horaanlika-droid/pacific/docs/visualization/sborka/PK-900_step3_fronts_all.png

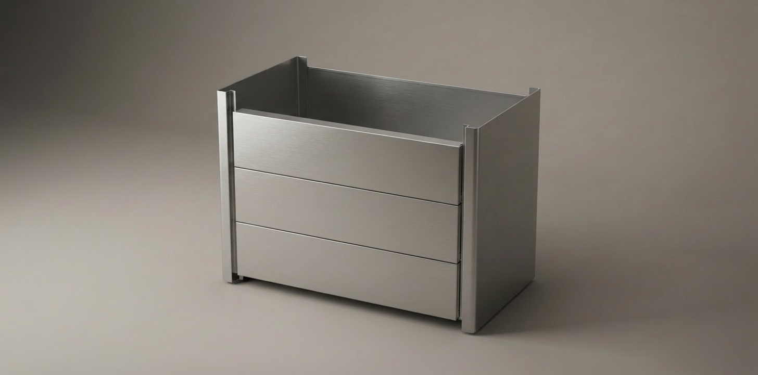
docs/visualization/sborka/PK-900_step3_fronts_all.png
