horaanlika-droid/pacific/docs/visualization/sborka/PK-900_step5_tray_done.png

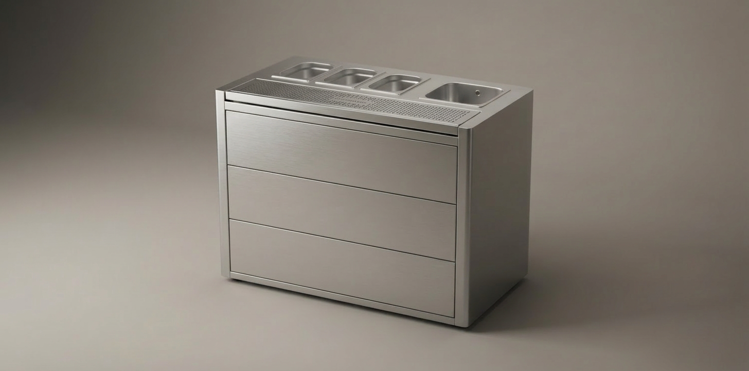
docs/visualization/sborka/PK-900_step5_tray_done.png
