horaanlika-droid/pacific/README.md

# ПАСИФИК ТУРБО · PK-900

Мобильная барная станция из нержавеющей стали AISI 304 для выездных мероприятий.
Металлические элементы вырезаются по отдельности из цельного листа и формуются гибкой;
соединения стойки — без болтов и винтов, по принципу «катана в ножны»: направляемая
скользящая посадка, крючки и пазы. На лотке — сквозная перфорация-логотип «ПАСИФИК ТУРБО»
в динамике советской спортивной эмблемы.

- Габариты в сборе: **900 × 600 × 1050 мм** (борт выдачи 1050 мм, рабочая часть 850 мм — на высоте бедра)
- Масса по параметрической геометрии (рев. D+): металл ≈ 29,7 кг, без чехла (чехол из проекта убран)

## Состав (8 металлических деталей)

| № | Элемент | Развёртка | t | Масса |
|---|---|---|---|---|
| 1 | Стенка боковая левая (ступенчатая 1020 / 820, ребро жёсткости) | 654 × 1071 | 1,2 | 5,67 кг |
| 2 | Стенка боковая правая (зеркально) | 654 × 1071 | 1,2 | 5,67 кг |
| 3 | Фасадный блок нижний | 900 × 375 | 1,2 | 3,21 кг |
| 4 | Фасадный блок средний | 900 × 375 | 1,2 | 3,21 кг |
| 5 | Фасадный блок верхний | 900 × 375 | 1,2 | 3,21 кг |
| 6 | Зона выдачи — перфорированный лоток-каплеуловитель | 900 × 191 | 1,0 | 1,04 кг |
| 7 | Рабочая зона — столешница с вырезами (рёбра жёсткости) | 956 × 516 | 1,2 | 3,42 кг |
| 8 | Перегородка внутренняя (зона льда / мойка, вертикальное ребро) | 502 × 888 | 1,2 | 4,24 кг |

## Что в репозитории

```
cad/pk_geom.py    параметрическая геометрия деталей (мм, K-фактор 0,33)
cad/pk_dxf.py     экспорт DXF: CUT / BEND / INFO / SHEET + раскладка листов
cad/pk_draw.py    чертёжные примитивы и изометрия (reportlab)
cad/pk_album.py   14-листовой альбом A3
docs/             ПАСИФИК_КИТ_альбом.pdf — проект целиком
dxf/              11 DXF деталей (E1–E7, E9, E8.x) + раскладка + INDEX.txt
```

## Принятые допущения

Отверстие мойки принято 300 × 240 мм под рамку GN 1/2 около 325 × 265 мм; проверьте фактическую рамку вашей
ёмкости до заказа резки. Кран в проект не входит (отверстий под фитинг нет). Скользящая посадка и безболтовые замки требуют
контрольной сборки и проверки устойчивости/нагрузки до эксплуатации.

## Сборка

```bash
cd cad
python3 pk_geom.py     # проверка массогабаритов
python3 pk_dxf.py      # dxf/*.dxf + раскладка + INDEX.txt
python3 pk_album.py    # docs/ПАСИФИК_КИТ_альбом.pdf
python3 pk_render.py   # docs/ПАСИФИК_КИТ_визуализация.png
```

Зависимости: `reportlab`, `ezdxf`, `numpy`, `matplotlib` (для попап-версии также `shapely`) (Python 3.11).

## Ключевые решения

- Фасад — три блока 900 × 334 с зазорами 3 мм, лицо 1008 мм; блоки заменяются отдельно.
- Сборка стойки без крепежа: лицевые блоки E3–E5 (ширина 896,6 мм, зазор 0,5 мм) входят
  сверху в вертикальные направляющие-рельсы на внутренней стороне боковин (E1, E2) и снимаются
  вверх; блоки сцепляются шипами, столешница опускается в направляющий зазор на опорные полки.
  Окончательные допуски скользящей посадки должны быть подтверждены контрольным образцом.
- Зона выдачи — съёмный гнутый лоток с продолговатой перфорацией и логотипом «ПАСИФИК
  ТУРБО»; стандартная перфорация освобождает место под надпись. Геометрию дренажа уточнить
  под выбранную ёмкость до выпуска в производство.
- Рабочая поверхность (столешница E7) опущена до **850 мм** (−200 мм от борта выдачи 1050 мм, на высоту бедра бармена) для удобной работы с шейкером, мойкой и льдом; боковые стенки выполнены ступенчатыми (1020 / 820 мм).
- Рабочая зона: сохранены 4 выреза 90 × 160 R8 под малые гастроёмкости; вместо отдельных
  раковин — одно отверстие 300 × 240 R12 под опорную рамку большой съёмной гастроёмкости GN 1/2, используемую
  как мойка. Удалены вырезы под ринсер, кабельный ввод и прямоугольный ввод коммуникаций.
  Кран удалён из проекта по указанию заказчика. Внутренняя перегородка E9 (лист 1,2 мм, 502 × 888, полки 25 и 20 мм, ребро жёсткости; глубина 58–560 мм, за плоскостью фасадов) делит зону льда (4 × GN 1/9) и мойку (GN 1/2) и опирается на низ столешницы и пол.

## Попап из фанеры

Отдельная версия PK-POP-900: [концепция](docs/popup/PK-POP-900_concept.md),
[план отверстий](docs/popup/PK-POP-900_otverstiya.png) и
[файлы отдельных деталей для ЧПУ](docs/popup/cnc/README.md). Рабочая плита и
плита выдачи — фанера со сквозными вырезами; раскладка предварительная и требует
проверки в CAM перед резкой.
