horaanlika-droid/pacific/docs/popup/cnc/README.md

# PK-POP-900 · файлы для ЧПУ

Фанера берёзовая 12 мм, листы 1220 × 2440 мм. Единицы — мм, DXF R2010.

- `PK-POP-01 … 07` — отдельные детали (по одной на файл; количество — в концепции).
- `PK-POP-07` — выдача: плита 900 × 140 со слотами и логотипом (сквозной рез).
- `PK-POP-NEST_sheet1/2.dxf` — раскрой на листы.
- Слои: `CUT` — рез, `DRILL` — Ø4 под винты, `TEXT` — подписи (не резать).
- Вставка мойки — покупная, не в DXF.
- Механизм складывания не нанесён: ждём выбор варианта A или B.
- Генератор: `cad/pk_popup.py`.

## Отверстия в фанерных деталях

- `PK-POP-03_столешница_рабочей_зоны.dxf` — сама фанерная плита
  900 × 460 × 12 мм со сквозными вырезами: четыре 90 × 160 R8 под
  ёмкости и один 300 × 240 R12 под мойку. Начало координат — левый
  нижний угол плиты; левый нижний угол вырезов GN: (48, 55), (156, 55),
  (264, 55), (372, 55); мойки — (535, 55), мм.
- `PK-POP-07_выдача.dxf` — сама фанерная плита 900 × 140 × 12 мм;
  слоты и рисунок логотипа также вырезаются сквозь фанеру. Это не отдельная
  металлическая накладка. Схема обеих деталей: `../PK-POP-900_otverstiya.png`.
- Контуры отверстий находятся внутри контура детали на слое `CUT`; материал
  внутри них удаляется, а не добавляется как отдельная деталь. `DRILL` —
  отдельные предварительные отверстия под крепёж.

**До передачи в производство:** раскладка NEST предварительная: детали в ней
соприкасаются, нет отступа под диаметр фрезы, припуск и прижим. Выполнить
раскладку заново в CAM по отдельным DXF. Надпись «ПАСИФИК ТУРБО» выполнена сквозным трафаретом с перемычками,
без оторванных внутренних островков. Ширина штрихов и слотов 7 мм, радиус
их закруглённых концов 3,5 мм — под фрезу Ø6 мм с запасом 0,5 мм на сторону.
Резать внутренние контуры с компенсацией по внутренней стороне, сделать пробу
и проверить тонкие перемычки и прочность фанеры у изготовителя. Ø4 на слое
DRILL сверлить отдельным сверлом Ø4, фреза Ø6 их не выполнит. Проверить размеры
ёмкостей, крепёж, опору плиты выдачи и влагозащиту всех кромок. Файлы —
концепция, не утверждённое производственное задание.

Генерация: `python cad/pk_popup.py` и `python cad/pk_popup_plan.py`;
зависимости: `ezdxf`, `shapely`, `matplotlib`.
