horaanlika-droid/pacific/docs/flat/PK-FLAT-900_concept.md

# ПАСИФИК ТУРБО · PK-FLAT-900 — конструктор из плоского листа (рев. E)

Статус: **концепция + раскрой для лазера, не инженерный расчёт.** Осуществимость
подтверждена геометрией: 0 гибов, 0 сварки, сборка без инструмента. Узлы и
допуски проверить на макете до заказа металла.

## Задача

Металлическая станция 900 × 600 × 1050 мм из AISI 304, собранная **без единого
гиба**: только вырезанные лазером плоские листы, входящие друг в друга
«лист в лист». В разборе — один плоский пакет.

## Ответ: да, но цена — масса

| | рев. D (гнутая) | **рев. E (плоская)** |
|---|---|---|
| Гибов | 39 | **0** |
| Сварки / крепежа | точечная сварка | 0 / 16 чек Ø4 (необязательно) |
| Деталей | 8 | 13 наименований / 18 шт. |
| Масса | 29,7 кг | **41,2 кг** (+11,6) |
| Пакет в разборе | ≈220–260 мм | **940 × 1030 × 58 мм** |
| Сборка вдвоём | 5–8 мин | 15–20 мин |
| Металл + резка | 33 700 ₽ | 27 000–34 000 ₽ |

Плоская версия тяжелее, потому что вся жёсткость берётся из листа: боковины
набраны полосами, коробка замкнута, лоток — сэндвич из трёх слоёв. Зато нет
гибочного участка, а упаковка в 4 раза тоньше.

## Принцип: шов вместо гиба (J1)

Боковина не гнётся, а **набрана полосами по уровням**, и швы совпадают с
уровнями горизонтальных плит:

```
1050,0 ─┐ ложное дно F10 (торец)
1048,8 ─┼─ бортик F4
1020,0 ─┼─ дно лотка F7 (торец)
1018,8 ─┼─ стойка F3
 850,0 ─┼─ столешница F6 (торец)
 848,8 ─┼─ боковина F2
  21,2 ─┼─ дно F5 (торец)
  20,0 ─┴─ плинтус F1
```

Торец горизонтального листа занимает в плоскости боковины ровно 1,2 мм — это и
есть шов. Стык работает на сжатие «металл в металл», без крепежа и без
отбортовки. Нагрузка идёт по металлу вниз, а не через зазор.

## Четыре типа соединений

| Код | Узел | Как устроен |
|-----|---|---|
| **J1** | шлиц-стык | торец плиты зажат между двумя полосами боковины |
| **J2** | шип-паз | шип **заподлицо**: выступ 1,2 мм (= t), из паза выходит ≤ 0,25 |
| **J3** | гребень | F11 → F12: шип 6,8 мм внутри фасадного сэндвича, спереди заподлицо |
| **J4** | сэндвич | лоток: дно F7 + бортики F8/F9/F4 + ложное F10 = коробка 30 мм |

Шипы и пазы строятся **одной записью в координатах станции** (`pk_flat.py`,
`tab()` / `slot_for()`), поэтому деталь не может «разъехаться» с ответной:
шип 30 мм → паз 30,5 × 1,45.

## Детали

| Код | Деталь | Размер, мм | Шт. | Масса, кг |
|-----|---|---|-----|---|
| F1 | Плинтус боковины | 600 × 20 | 2 | 0,11 |
| F2 | Боковина нижняя | 600 × 828 | 2 | 4,73 |
| F3 | Стойка боковины | 140 × 169 | 2 | 0,23 |
| F4 | Бортик боковины (лоток) | 140 × 29 | 2 | 0,04 |
| F5 | Дно | 900 × 600 | 1 | 5,14 |
| F6 | Столешница (4 × GN 1/9 + мойка GN 1/2) | 900 × 581 | 1 | 3,74 |
| F7 | Дно лотка выдачи (дренаж Ø30) | 900 × 140 | 1 | 1,19 |
| F8 | Бортик лотка (перед / зад) | 898 × 29 | 2 | 0,25 |
| F10 | Ложное дно (перфорация, трафарет) | 898 × 120 | 1 | 0,92 |
| F11 | Фасад нижний (2 шлица) | 898 × 828 | 1 | 7,03 |
| F12 | Фасад верхний (барьер) | 898 × 169 | 1 | 1,44 |
| F13 | Задняя панель | 900 × 828 | 1 | 7,09 |
| F14 | Перегородка лёд / мойка | 502 × 828 | 1 | 3,95 |
| F15 | Чека Ø4 × 18 (пруток) | Ø4 × 18 | 16 | 0,3 м |

Итого: 4,33 м², 41,2 кг, рез 51,6 м. Раскрой: 2 листа 1250 × 2500
(S1 — 14 деталей, 2,53 м²; S2 — 4 детали, 1,80 м², 58 %).

## Пакет в разборе

18 листов + 18 прокладок 2 мм (войлок/картон) → **940 × 1030 × 58 мм, 41 кг**.
Две стяжки, угловые накладки, ремень. Мойка, бутыль для дренажа и U-профиль
уезжают отдельно, в той же сумке.

## Допуски

- паз = t + 0,25 = **1,45 мм**; первый комплект — с зазором 0,25, туго → 0,15,
  болтается → чеки Ø4 / заклёпки;
- шип **заподлицо**: выступ 1,2 мм, из паза выходит не более 0,25 мм;
- гребень F11 → F12 — 6,8 мм (спрятан в фасаде);
- внутренние углы пазов и шлицев — **R0,5** (тонкий лист не любит острых
  входящих углов);
- кромки притупить 0,3 × 45°, фасад и столешницу — шлифовка 400 → 600;
- U-профиль 1,5 мм на верхнюю кромку фасада и на кромки лотка.

## Порядок сборки (12 шагов, 15–20 мин вдвоём)

F5 → F1 → F2 → F13 → F14 → F11 → F6 → F12 → F3 → F7 → F8/F9 + F4 → F10.
Разборка — строго наоборот.

## Файлы

- `PK-FLAT-900_альбом.pdf` — альбом A3, 6 листов: обложка, узлы, слои и укладка,
  спецификация и раскрой, сборка, смета и риски.
- `cnc/PK-FLAT-F*.dxf` — 13 деталей 1:1 в координатах станции (деталь = проекция
  станции), слои `CUT` / `INFO` (подписи не резать).
- `cnc/PK-FLAT-NEST_s1.dxf`, `cnc/PK-FLAT-NEST_s2.dxf` — раскрой на листы.
- `cad/pk_flat.py` — параметрика, соединения, проверки (`python pk_flat.py`).
- `cad/pk_flat_dxf.py` — выгрузка DXF и NEST.
- `cad/pk_flat_album.py` — сборка альбома (`python pk_flat_album.py`).

## Проверки в модели

`python cad/pk_flat.py` → «Проверка кромок: OK», «Проверка объёмов (шипы): OK»:
пазы не ближе 6 мм к углу, не пересекаются, шипы не входят в объём чужих деталей.

## Открыто

1. Макет узла J1 (F1–F2–F5) и шип-паз в натуральную величину: зазор и усилие.
2. Столешница на 60 кг (прогиб ≤ 1 мм), полка лотка на 20 кг.
3. Дренаж и крепление мойки (мойка — покупная GN 1/2).
4. Перекос коробки: при качании — задняя панель на 8 заклёпок.
5. Раскрой предварительный: проверить в CAM цеха (зазор между деталями 8 мм).
