horaanlika-droid/pacific/docs/popup/PK-POP-900_concept.md

# ПАСИФИК ТУРБО · попап-версия из берёзовой фанеры 12 мм — концепция (рев. 2)

Статус: **концепция и раскрой для ЧПУ, не инженерный расчёт.** Крепёж и механизм складывания предварительные, их нужно проверить на макете.

## Исходные данные

- Габарит в собранном виде: **900 × 600 × 1050 мм**, как у станции из нержавейки.
- Материал: **берёзовая фанера 12 мм** — боковины, дно, рабочая зона, плита выдачи, фасады, перегородка, рейки.
- Стальная остаётся только **вставка мойки** (GN 1/2): фанера не даёт санитарной поверхности и не держит воду. Подтвердить.
- Складывание в чемодан — вариант A или B, выбор после макета (см. «Открыто»).

## Детали (13 шт. фанеры)

| Код | Деталь | Размер, мм | Шт. | Примечание |
|-----|---|---|-----|---|
| PK-POP-01 | Боковина | 600 × 1038 (профиль: 1038 спереди, 838 под столешницей) | 2 | зеркально; Ø4 под винты в торец дна и в рейки |
| PK-POP-02 | Дно | 876 × 600 | 1 | между боковинами |
| PK-POP-03 | Столешница (рабочая зона) | 900 × 460 | 1 | 4 × GN 1/9 (90 × 160, R8) и вырез мойки (300 × 240, R12) |
| PK-POP-07 | Выдача (плита лотка) | 900 × 140 | 1 | слоты 40 × 7 и трафарет ПАСИФИК ТУРБО — сквозной рез фрезой Ø6 |
| PK-POP-04 | Фасадный блок | 875 × 334 | 3 | ход в каналах; вырез под палец 80 × 20 сверху |
| PK-POP-05 | Перегородка | 502 × 826 | 1 | x = 498 от левой кромки; от дна до низа столешницы |
| PK-POP-06 | Рейка направляющей | 1008 × 40 (толщина 12) | 4 | по две на боковину; канал 12,5 мм для фасада |

Металл: **вставка мойки GN 1/2** — покупная, не в DXF.

Высоты: выдача 1050 = боковины 1038 + плита выдачи 12; рабочая плоскость 850 = боковина 838 + столешница 12; низ фасадов — 12 мм от пола.

## Раскрой

- **2 листа 1220 × 2440 мм.**
- Площадь деталей 3,76 м² из 5,95 м² листов (~63 %).
- Схема: `PK-POP-900_raskroy.png`. DXF: `cnc/PK-POP-NEST_sheet1.dxf`, `cnc/PK-POP-NEST_sheet2.dxf`.

## Файлы для ЧПУ (`docs/popup/cnc/`)

- `PK-POP-01 … 07` — отдельные детали (по одной на файл).
- `PK-POP-NEST_sheet1/2.dxf` — раскрой на листы.
- Слои: `CUT` — рез по контуру; `DRILL` — отверстия Ø4 (винты); `TEXT` — подписи, не резать.
- Фасадный вырез, вырезы столешницы и слоты выдачи — контуры в слое `CUT`. Перед резкой проверить направление обхода в CAM.
- **Механизм складывания не нанесён** — добавим после выбора варианта A или B.

## Ограничения фанеры

- **Мойка — стальная вставка.** Подтвердить до резки столешницы.
- **Плита выдачи** держится на боковинах без поперечины. Прогиб под стаканами проверить на образце; при необходимости — поперечина из 12 мм под плитой.
- **Слив и влага:** плита плоская, уклона к дренажу нет. Покрыть маслом или лаком; для станции на улице — отдельный вопрос.
- **Жёсткость:** 12 мм берёза под столешницей 60 кг — проверить на образце, прогиб ≤ 1 мм.

## Складывание (предварительно)

- **A — откидной:** боковины на навесах к дну, складываются внутрь; столешница, плита и фасады — вынимаются в чемодан.
- **B — телескопический:** коробка сложена, столешница и фасады выдвигаются по направляющим, фиксируются штифтами на 1050 мм.

## Открыто

1. Вариант складывания: A или B.
2. Вставка мойки — сталь (по умолчанию) или иное решение.
3. Поперечина под плитой выдачи — нужна ли (проверка прогиба).
4. Размер чемодана в сложенном виде.
5. Фурнитура: навесы, штифты, направляющие — сорт и поставщик.
6. Испытание: образец столешницы 60 кг, прогиб ≤ 1 мм.
7. Цена: в этой версии не оценивалась — нет проверенных источников на берёзовую фанеру 12 мм.

## Файлы

- Генератор деталей и раскроя: `cad/pk_popup.py`.
- Презентация и схемы: `cad/pk_popup_deck.py` → `PK-POP-900_prezentatsiya.pptx`.

## Фанерные детали с отверстиями

Рабочая столешница **PK-POP-03** и плита выдачи **PK-POP-07** — обе из
фанеры 12 мм. Отверстия под ёмкости, мойку, слоты выдачи и логотип являются
сквозными внутренними контурами этих плит, а не металлическими деталями.
Вид сверху: `PK-POP-900_otverstiya.png`; отдельные контуры 1:1 и координаты —
в `cnc/`. Покупные ёмкости и вставка мойки в фанерный раскрой не входят.

Раскладка NEST только ориентировочная: детали соприкасаются, поэтому до резки
её нужно выполнить заново с технологическими зазорами. Трафарет выполнен штрихами шириной 7 мм с перемычками; его прочность
и прочность выдачи требуют проверки изготовителем; торцы отверстий необходимо
защитить от влаги.
