horaanlika-droid/pacific/docs/PK-900_smeta.md

# ПАСИФИК ТУРБО · PK-900 — смета на изготовление (рев. D+, 08.11.2026)

Состав: 8 металлических деталей AISI 304 (E1–E7, E9 — внутренняя перегородка).
Работы цеха: лазерная резка и гибка. Зачистка кромок и сборка — выполняет заказчик.
**Не входят:** чехол-сумка (убран из проекта), кран (убран), оборудование (гастроёмкости, мойка).

Цены ориентировочные, в рублях. Где цена взята с сайта поставщика — указан источник.
**«Оценка»** — моё допущение без источника, его нужно заменить коммерческим предложением.

## Что изменилось в рев. D+ (относительно рев. D)

- **Боковые стенки E1, E2:** вертикальные направляющие-рельсы для лицевых блоков E3–E5 (две ноги на каждую сторону, гиб 15 мм внутрь, низ с 12 мм над полом). Гибов +4 (всего 39).
- **Фасады E3–E5:** крючки-язычки и пазы убраны. Торцы входят в рельсы сверху, снимаются вверх. Ширина блока 896,6 мм (зазор 0,5 мм до каждой боковины).
- **Перегородка E9:** сдвинута за фасады (глубина 58–560 мм, развёртка 502 мм). Масса 4,24 кг.
- **Рабочая зона E7 и выдача E6:** без изменений по геометрии. Выдача E6 — перфорированный лоток.
- **Логотип «ПАСИФИК ТУРБО» на E6:** крупнее (ячейка 3,6 мм, зазор 0,5 мм), добавлены две сплошные скоростные полосы под надписью.
- Листы без изменений: боковые стенки E1, E2, столешница E7 и перегородка E9 — **1,2 мм**; фасады E3–E5 — 1,2 мм; лоток E6 — 1,0 мм.
- Жёсткость — за счёт геометрии, а не толщины (рёбра из рев. D сохранены): ребро на боковинах от рельса до задней отбортовки, два ребра на столешнице по ширине, вертикальное ребро на перегородке.
- Масса металла: **29,7 кг** (было 30,0 кг в рев. D; 34,8 кг в рев. C).
- Гибов: **39** (было 35 в рев. D, 25 в рев. C).
- Чехол убран: позиции чехла и его перегородок из сметы исключены.

## 1. Материал (AISI 304)

Вес листов — по плотности 7,93 г/см³.

| № | Позиция | Вес, кг | Цена, ₽/кг | Сумма, ₽ | Источник цены |
|---|---|---|---|---|---|
| М1 | Лист 1,2 мм, 1250×2500 (S1: E1, E2, E7, E9) | 29,7 | 380 | 11 286 | оценка: интерполяция между 1,0 и 1,5 мм (rusevromet.ru: 1,0 мм — 350, 1,5 мм — 370 ₽/кг) |
| М2 | Заготовка 1,2 мм, 1250×1200 (S2: E3, E4, E5) | 14,3 | 380 | 5 424 | то же |
| М3 | Заготовка 1,0 мм, 1000×500 (S3: E6) | 4,0 | 350 | 1 388 | rusevromet.ru — 1,0 мм, 1000×2000, 350 ₽/кг |
| | **Итого материал** | | | **18 098** | |

Листы те же (S1, S2, S3); раскрой в `dxf/PK-NEST_all_sheets.dxf` пересобран по новым развёрткам (фасады на 3,4 мм уже, перегородка на 38 мм уже). Пригодность раскроя в каждом листе нужно подтвердить в программе цеха до заказа.
Если металл покупаете сами — позиции М1–М3 из сметы выпадают.
Цена 1,2 мм в найденных источниках не указана: это интерполяция, её нужно подтвердить.

## 2. Услуги цеха

| № | Позиция | Расчёт | Сумма, ₽ | Источник / основание |
|---|---|---|---|---|
| У1 | Лазерная резка, ~41 м реза | расчёт ~535 ₽ (1,2–1,5 мм ≈ 12–15 ₽/м, 1,0 мм ≈ 11 ₽/м), но не ниже минимального заказа | 7 000 | ПК «Антей»: 1,5 мм — 15 ₽/м, минимальная сумма заказа 7 000 ₽ (antaeus.ru) |
| У2 | Гибка, 39 гибов | 39 × 65 ₽ | 2 535 | ПК «Антей»: гибка нержавейки 65 ₽/гиб при 1–50 гибах (antaeus.ru) |
| | **Итого услуги** | | **9 535** | |

Зачистка кромок и контрольная сборка в смету не входят: их делает заказчик.

## 3. Комплектующие

Нет. Чехол, его перегородки и накладки убраны из сметы.

## 4. Логистика и упаковка

| № | Позиция | Сумма, ₽ | Основание |
|---|---|---|---|
| Л1 | Доставка деталей по Петербургу и упаковка листовых деталей | 3 000 | оценка |

## 5. Итог

| | Металл у цеха, ₽ | Металл у заказчика, ₽ |
|--|---|---|
| Материал (М1–М3) | 18 098 | — |
| Услуги цеха (У1–У2) | 9 535 | 9 535 |
| Комплектующие | 0 | 0 |
| Логистика (Л1) | 3 000 | 3 000 |
| **Итого без резерва** | **30 633** | **12 535** |
| Резерв 10 % (доработка, брак гибки) | 3 063 | 1 254 |
| **Итого с резервом** | **33 696** | **13 789** |

Для сравнения: рев. D — 33 410 ₽ / 13 503 ₽; рев. C (1,5 мм, с чехлом и ручным трудом) — 62 690 ₽ с металлом у цеха.

## 6. Что не входит в смету

- Гастроёмкости GN 1/9 (4 шт.) и съёмная мойка GN 1/2 — подбираются по месту.
- Кран и подводка воды — удалены из проекта.
- Зачистка кромок, контрольная сборка, покраска или защитная плёнка — выполняются заказчиком.
- НДС: часть цен на сайтах с НДС, часть без. Итог уточнить в коммерческом предложении.
- Цены на сайтах — снимок на 08.11.2026. Реальные условия подтверждаются письменным КП.

## 7. Риски и что проверить до заказа

1. **Жёсткость столешницы и боковин на 1,2 мм.** Расчёт на рёбрах — инженерная оценка, не испытание.
   Нужен контрольный образец: нагрузка 60 кг в центр столешницы, допустимый прогиб ≤ 1 мм. Если не пройдёт —
   вернуть столешницу на 1,5 мм (+0,85 кг; если отдельным листом 1,5 мм — около +5 тыс. ₽ к материалу).
2. **Рельсы боковин.** Гибы направляющих (U-канал на 18 мм ширины, 15 мм внутрь) — проверить на опытной детали: зазор фасада 0,5 мм, ход вверх без заеда.
3. Сопряжение рёбер столешницы с перегородкой и отгибов перегородки в раскрое: проверить на развёртке перед резкой.
4. Минимальный заказ резки и гибки в выбранной мастерской (заложено 7 000 ₽). Если найти резку без минимума,
   итог упадёт примерно на 6 000 ₽.
5. Цена листа 1,2 мм — подтвердить у поставщика.
