horaanlika-droid/pacific/docs/ПАСИФИК_КИТ_альбом.pdf

# ПАСИФИК ТУРБО

## PACIFIC TURBO · PK-900

# разборная барная станция из нержавеющей стали · для выездных мероприятий

## альбом проекта

## ПАСИФИК ТУРБО · сборка без болтов · скользящая посадка

### рев. C · 08.11.2026 · 14 листов + 12 DXF

## 900 × 600 × 1050 мм · ≈ 30,0 кг

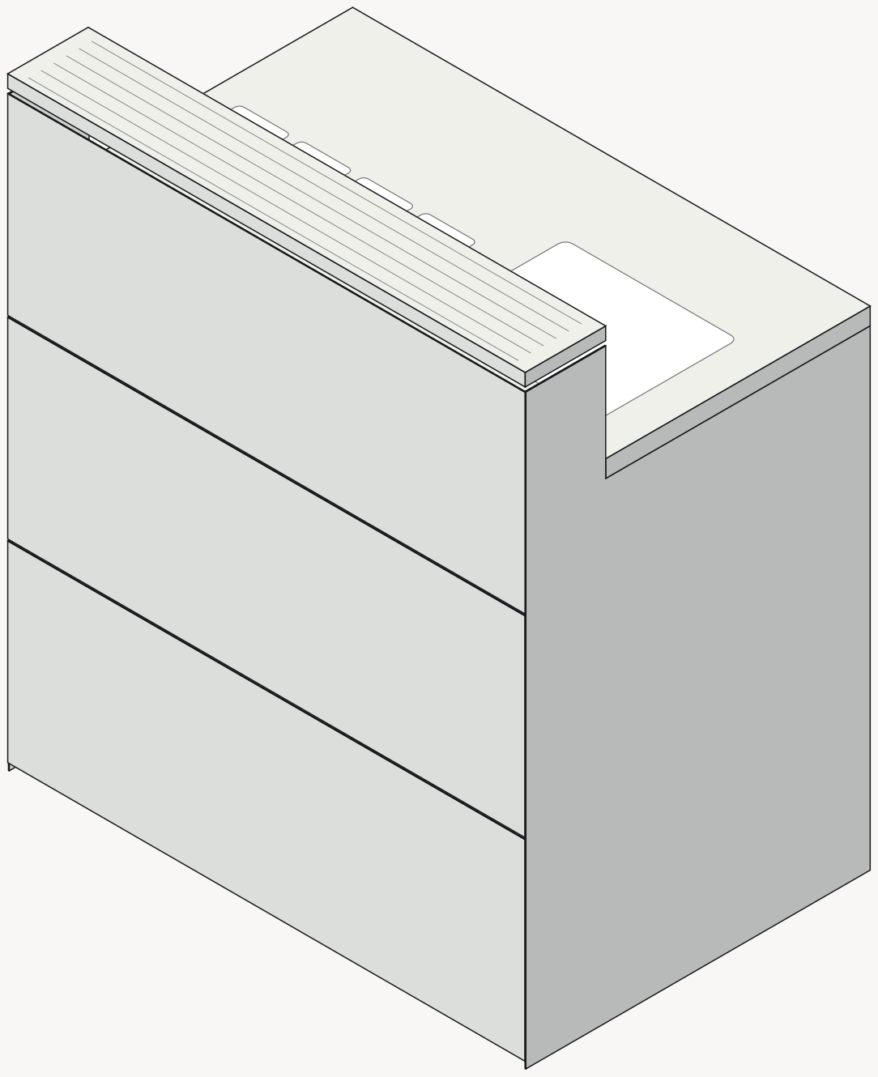
[picture p6: figure]

8

металлических элементов
900 × 600 × 1050

габарит в сборе, мм (рабочая 850)
1180 × 720 × 145

чехол в сложенном виде, мм
0,12 м³

объём в упаковке

# 5–7 мин

сборка вдвоём, без инструмента
≈ 30,0 кг

полная масса металла, оценка

Состав: концепция · общие виды · сборка · спецификация · 8 чертежей элементов · узлы · чехол · порядок сборки · производство · эксплуатация | масштабы 1:12 / 1:10 / 1:9 / 1:8 / 1:6 / 1:5 / 1:2 / 1:1

ПАСИФИК КИТ | мобильная барная станция · 900 × 600 × 1050 · 9 элементов | PK-900 · рев. B · 08.11.2026
КОНЦЕПЦИЯ | задача · схема · ключевые решения

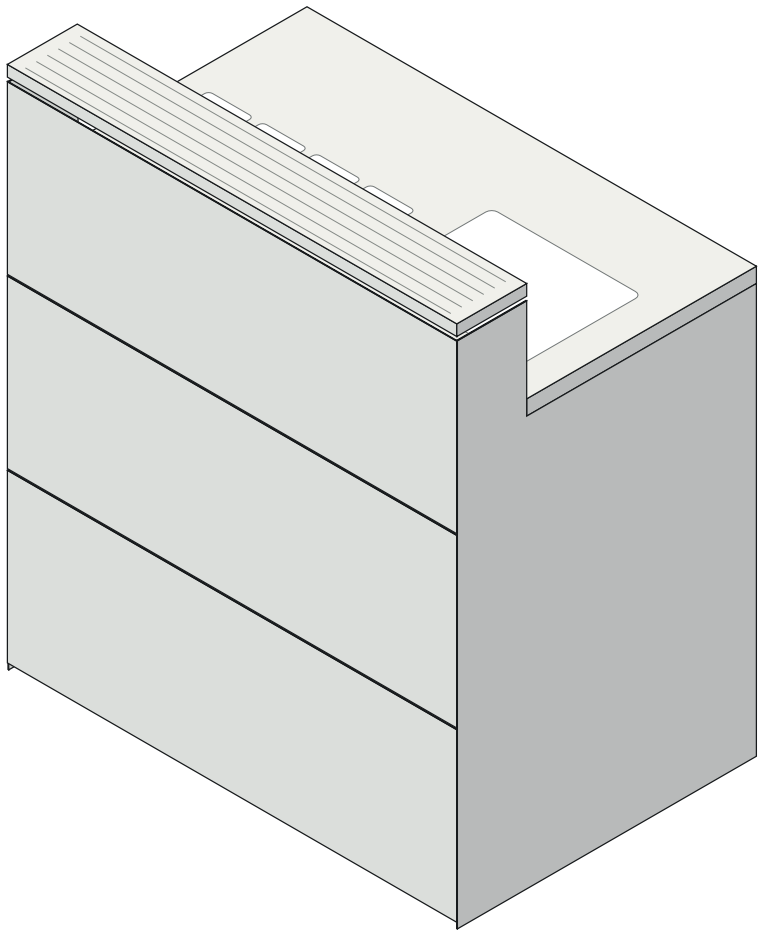
[picture p7: figure]

ПАСИФИК КИТ · PK-900 · альбом проекта и комплект DXF · размеры в мм · материал AISI 304 | лист 2 / 14

PK-900 · рев. C

### ЗАДАЧА

Барная станция для выездных мероприятий: кейтеринг, поп-ап бары, кофе-поинты, презентации. Два поста, работа стоя, гости — с фронта,

### бармен — с тыльной стороны. Перевозится одним человеком в багажнике, разворачивается на площадке за 5–7 минут без инструмента

и так же быстро убирается.

### ПРИНЦИП: ВОСЕМЬ МЕТАЛЛИЧЕСКИХ ДЕТАЛЕЙ

### Все элементы — плоские листовые детали из AISI 304 толщиной 1,0–1,5 мм с отбортовками. Ни одной объёмной рамы, ни одной растяжки, ни одного крепёжного элемента, выступающего за плоскость. В сложенном

виде комплект — стопка листов в жёстком чехле-сумке на колёсах.

№ | элемент | роль в конструкции
1–2 | боковые стенки | силовые: стоят на полу, несут столешницу и фасад
3–5 | 3 фасадных блока | лицевая стенка; три листа с отбортовками = диафрагма
6 | зона выдачи, перфорация | каплеуловитель с дренажом; распорка
7 | рабочая зона, вырезы | 4 GN 1/9 + съёмная мойка GN 1/2; диафрагма
8 | внутренняя перегородка | делит зону льда и мойку; опора столешницы
9 | чехол-сумка | транспортная тара, укладка «сэндвичем»

### КОНСТРУКТИВНАЯ СХЕМА

### Две ступенчатые стенки (1, 2) образуют раму: передняя стойка 1020 мм

несёт фасад и выдачу (1050 мм), а рабочая часть опущена до 820 мм.

Спереди стенки связаны тремя фасадными блоками (3, 4, 5), которые заводятся в пазы отбортовок и опускаются на 8 мм до упора — получается трёхслойная балка высотой 1008 мм. Столешница рабочей зоны (7) садится на полку 820 мм (рабочая плоскость 850 мм — на высоте бедра бармена) и фиксируется скользящей посадкой на

интегральные опорные полки без болтов: замыкающая диафрагма.

### Перфорированный лоток (6) встаёт в проём зоны выдачи на отметке

1050 мм.

### СОБРАННАЯ СХЕМА

### Коробка замкнута в плане (фасад + столешница + две стенки) — это исключает складывание

«параллелограммом» без растяжек. Стенки стоят на полу отбортовкой 15 мм; при базе 900 × 600 и высоте 1050 запас по опрокидыванию более чем двукратный.

КЛЮЧЕВЫЕ ЦИФРЫ

в сборе
900 × 600 × 1050 мм
выдача 1050 / рабочая 850

в упаковке
1180 × 720 × 145 мм
0,12 м³ — в 4,6 раза меньше

масса
металл ≈ 30,0 кг
чехол из комплекта убран

сборка
5–7 мин вдвоём
8 мин одному

нагрузка
столешница 60 кг
равномерно / 40 кг в точке

ОБЩИЕ ВИДЫ | фасад · бок · план · разрез
ПАСИФИК КИТ · PK-900 · альбом проекта и комплект DXF · размеры в мм · материал AISI 304 | лист 3 / 14 масштаб 1:9 / 1:12

900

3 × 334 + 2 × 3

30

1008 1050

12

334

3

4

5

140 | 460

600

850

200

1050

лоток 6 — 1050

рабочая 7 — 850 (уровень бедра)

900

600

140
ПЛАН 1:12

фасад 3–5

столешница 7 (850)

лоток 6

створ 897 × 599 × 820
850

30

200

1050

140 | 460 РАЗРЕЗ А–А 1:12

ПРИМЕЧАНИЯ

1. Габарит в сборе 900 × 600 × 1050. Верхняя плоскость 1050 — лоток выдачи 6; рабочая часть (столешница 7) опущена до 850 (на 200 мм, уровень бедра) для удобной работы бармена и скрыта от гостя с фронта.
2. Фасад — три блока 900 × 334 с зазором 3 мм: блок можно заменить или забрендировать отдельно, не меняя станцию.
3. Зона выдачи — лоток 6: 140 мм по фронту, борт 1050, дно ниже кромки на 8 мм.

ПРИМЕЧАНИЯ

4. Рабочая зона — столешница 7 (850, уровень бедра): глубина 460 мм; слева 4 отсека 4 выреза GN 1/9 и отверстие 300 × 240 под рамку съёмной GN 1/2. Прежние лишние вырезы оборудования удалены.
5. Боковые стенки ступенчатые (1020 / 820 мм), утоплены за фасадом на 1,2 мм.
6. Внутренний объём под рабочей зоной — 4 ящика для бокалов 400 × 300 × 250.

СБОРКА В РАЗБОРЕ | 8 элементов и порядок установки

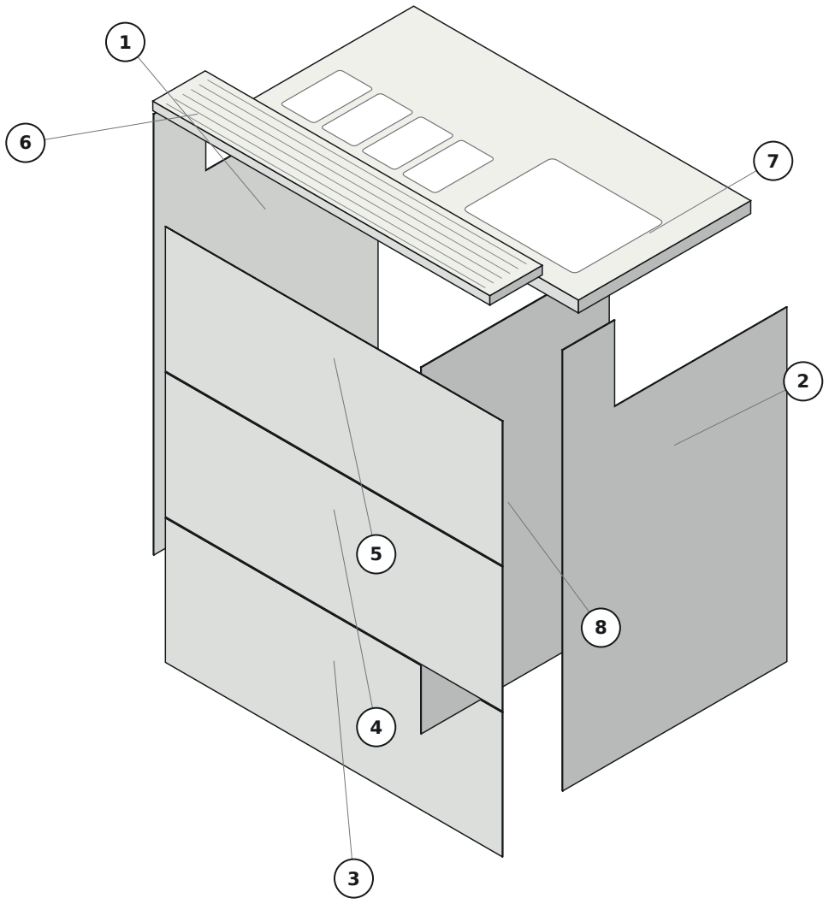
[picture p8: figure]

ПАСИФИК КИТ · PK-900 · альбом проекта и комплект DXF · размеры в мм · материал AISI 304 | лист 4 / 14

изометрия без масштаба

### СОСТАВ КОМПЛЕКТА

№ | элемент | материал / t | развёртка | масса
1 | Стенка боковая левая | 304 / 1.2 | 654×1071 | 5.69
2 | Стенка боковая правая | 304 / 1.2 | 654×1071 | 5.69
3 | Фасадный блок нижний | 304 / 1.2 | 897×375 | 3.19
4 | Фасадный блок средний | 304 / 1.2 | 897×375 | 3.19
5 | Фасадный блок верхний | 304 / 1.2 | 897×375 | 3.19
6 | Зона выдачи: перфорированный лоток | 304 / 1.0 | 900×191 | 1.03
7 | Рабочая зона: столешница с вырезами | 304 / 1.2 | 956×516 | 3.42
8 | Перегородка внутренняя | 304 / 1.2 | 502×888 | 4.24
9 | Чехол-сумка | PES/EVA/HDPE | 1180×720×145 | 4,20

Итого: металл ≈ 29.7 кг (оценка, без чехла). Собирается один человек за 8 минут, вдвоём — за 5–7.

ПОЧЕМУ ИМЕННО ВОСЕМЬ

Восемь несущих элементов плюс чехол — минимум, при котором станция остаётся жёсткой без растяжек: две стенки задают раму, три фасадных блока работают как диафрагма, столешница замыкает коробку сверху, лоток выдачи — распорка и каплеуловитель.

ПОРЯДОК

1 → 2 (стенки) → 8 (перегородка) → 3 → 4 → 5 (фасад снизу вверх) → 7 (столешница) → 6 (лоток) → оборудование. Разборка — строго в обратном порядке.

ЧТО В ЧЕХЛЕ, КРОМЕ ВОСЬМИ ДЕТАЛЕЙ

Ключ-бабочка, шаблон-шнур 900 мм, 4 опоры-клина, шланг дренажа Ø16, 12 демпферных накладок EVA, заглушки кромок, паспорт и упаковочная схема (лист 11). Все мелкие позиции — в двух карманах на внутренней стороне крышки.

СПЕЦИФИКАЦИЯ | элементы · крепёж · материал · раскрой
ПАСИФИК КИТ · PK-900 · альбом проекта и комплект DXF · размеры в мм · материал AISI 304 | лист 5 / 14

### ЭЛЕМЕНТЫ

Поз. | Наименование | Материал | t | Развёртка, мм | Кол. | Масса | DXF
1 | Стенка боковая левая | AISI 304 | 1.2 | 654 × 1071 | 1 | 5.69 | PK-E1
2 | Стенка боковая правая | AISI 304 | 1.2 | 654 × 1071 | 1 | 5.69 | PK-E2
3 | Фасадный блок нижний | AISI 304 | 1.2 | 897 × 375 | 1 | 3.19 | PK-E3
4 | Фасадный блок средний | AISI 304 | 1.2 | 897 × 375 | 1 | 3.19 | PK-E4
5 | Фасадный блок верхний | AISI 304 | 1.2 | 897 × 375 | 1 | 3.19 | PK-E5
6 | Зона выдачи: перфорированный лоток | AISI 304 | 1.0 | 900 × 191 | 1 | 1.03 | PK-E6
7 | Рабочая зона: столешница с вырезами | AISI 304 | 1.2 | 956 × 516 | 1 | 3.42 | PK-E7
8 | Перегородка внутренняя | AISI 304 | 1.2 | 502 × 888 | 1 | 4.24 | PK-E9
9 | Чехол-сумка транспортная | PES / EVA / HDPE | — | 1180 × 720 × 145 | 1 | 4,20 | лист 11
| ИТОГО металл | | | | 8 | 29.7

### СОЕДИНЕНИЯ СТОЙКИ — БЕЗ БОЛТОВ И ВИНТОВ

Поз. | Соединение | Кол. | Назначение
— | Интегральный крючок + паз | по геометрии | стенка — фасад
— | Шип + паз в отбортовке | по геометрии | фасадный блок — блок
— | Гнутые опорные полки / скользящая посадка | по геометрии | стенка — столешница
— | Крюк + паз | 2 | съёмный лоток — столешница
— | Полка 25 под столешницу, полка 20 на пол | по геометрии | перегородка — столешница / пол

### МАТЕРИАЛ И РАСКРОЙ

Лист | Материал | t | Формат | Детали | Кг
S1 | AISI 304, шлифовка | 1,5 | 1250 × 2500 | 1, 2, 7, 9 | 24,1
S2 | AISI 304, шлифовка | 1,2 | 1250 × 1200 | 3, 4, 5 | 11,9
S3 | AISI 304, перфорация | 1,0 | 1000 × 500 | 6 | 1,4

Все металлические детали стойки — отдельные цельные листовые заготовки AISI 304, без сварки для сборки. Развёртки посчитаны по нейтральной линии: K = 0,33, R внутр. 1,0 мм (t 1,5) и 0,8 мм (t 1,2; 1,0). Комплект DXF — 12 файлов (11 деталей и раскрой), мм, 1:1, слой CUT — рез, BEND — линия гиба.

### ТЕХНИЧЕСКИЕ ТРЕБОВАНИЯ

МАТЕРИАЛ | AISI 304 (08Х18Н10), лист холоднокатаный, шлифовка Scotch-Brite 240. Для декоративных блоков 3–5 допустим AISI 430.
ТОЧНОСТЬ | лазер ±0,2 мм; гибка ±0,5 мм по полке, 90° ±0,5°; плоскостность столешницы ±0,8 мм на 900 мм.
КРОМКИ | заусенец удалить, радиус 0,3–0,5 мм; кромки вырезов под гастроёмкости и мойки GN 1/2 — шлифовка R1,5 (санитарное требование).

ФОРМОВАНИЕ Металлические детали режутся из цельного листа и формуются гибкой; сварка не является способом сборки стойки.

ФИНИШ | матирование вдоль проката, обезжиривание, транспортная плёнка.
КОНТРОЛЬ | сборка «на сухую» на стенде: диагонали ±2 мм, зазоры фасада 3 ±0,5 мм, люфт столешницы не более 1 мм при нагрузке 60 кг.

ОБОРУДОВАНИЕ — В КОМПЛЕКТ НЕ ВХОДИТ, СТАВИТСЯ ПО МЕСТУ

Позиция | Типоразмер | Примечание
Гастроёмкости | GN 1/9 (176 × 108 × 65/100), 4 шт. | 4 выреза 90 × 160 R8
Мойка | съёмная GN 1/2, рамка около 325 × 265 | отверстие 300 × 240 R12
Кран | не предусмотрен | отверстий под фитинг нет
Дополнительные вырезыне предусмотрены | | ринсер / кабель / ввод удалены
Канистры | 2 × 10 л (вода/слив) + 3 л (лоток) | внутрь стойки (при необходимости)

РАБОЧАЯ ЗОНА — ЭЛЕМЕНТ 7 | вырезы под гастроёмкости · мойка GN 1/2

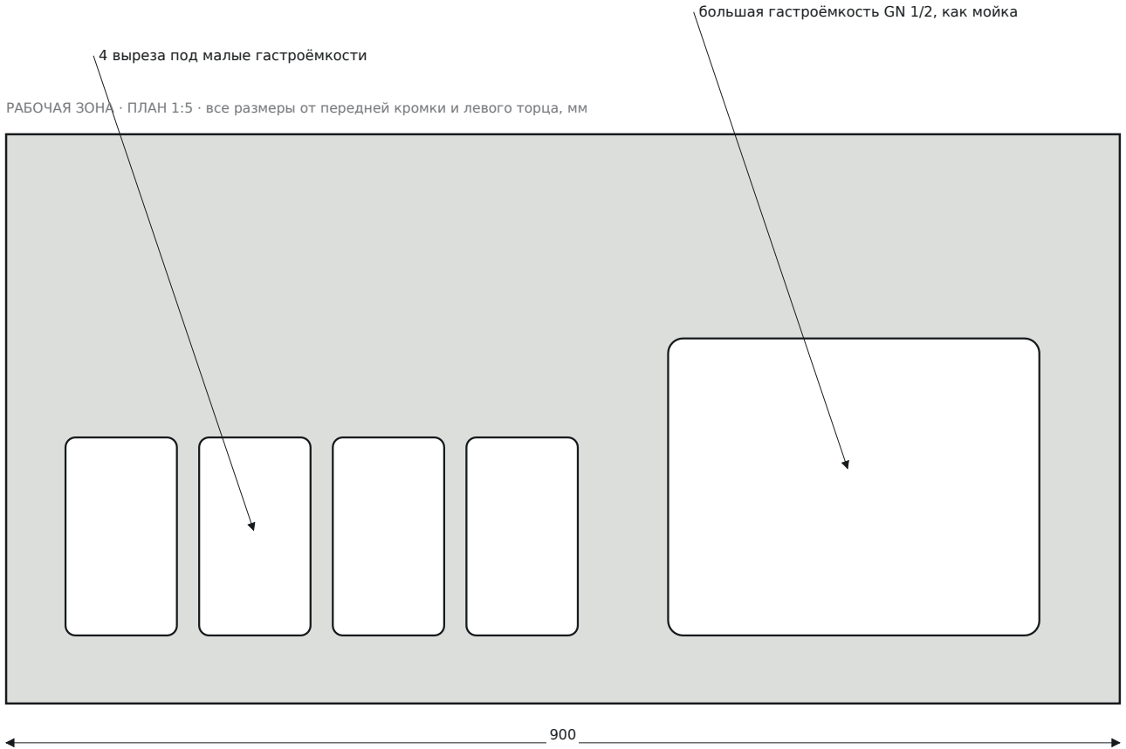
[picture p9: figure]
4 выреза под малые гастроёмкости; большая гастроёмкость GN 1/2, как мойка
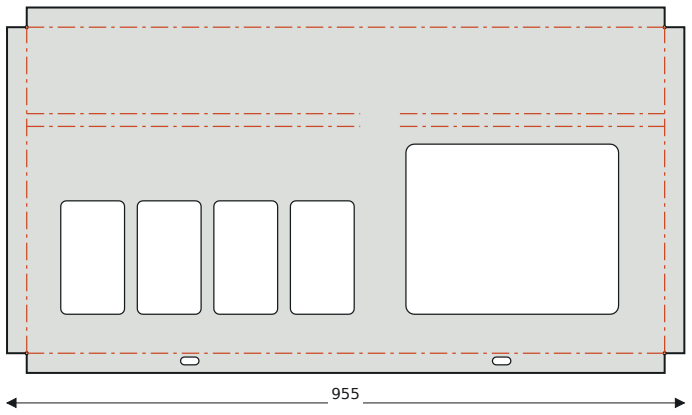
[picture p10: figure]

ПАСИФИК КИТ · PK-900 · альбом проекта и комплект DXF · размеры в мм · материал AISI 304 | лист 6 / 14 масштаб 1:5 / 1:10

460

РАБОЧАЯ ЗОНА · ПЛАН 1:5 · все размеры от передней кромки и левого торца, мм | ВЫРЕЗЫ И ПРИВЯЗКИ
Поз. | Назначение | Размер | X, мм | Y, мм
1–4 | Малые гастроёмкости | 90 × 160 R8 | 48…462 | 55…215
5 | Отверстие под GN 1/2 | 300 × 240 R12 | 535…835 | 55…295
6 | Крюки лотка | 26 × 11 | 230 / 670 | отбортовка

515

РАЗВЁРТКА 1:10 · цельный лист AISI 304 · отбортовка 30 мм

УЗЕЛ 7-Б · съёмная мойка GN 1/2 | 1:3

гастроёмкость вставляется сверху

300 × 240 · буртик под рамку GN 1/2

ПРИМЕЧАНИЯ

Сохранены четыре малых выреза под гастроёмкости. Вместо сварной/отдельной раковины — один широкий вырез под съёмную гастроёмкость GN 1/2, номинальная верхняя рамка 325 × 265 мм.

Кран не предусмотрен: отверстий под фитинг и смеситель в столешнице нет.

Удалены прежние вырезы под отдельные секции раковины, ринсер, кабельный ввод и прямоугольный ввод коммуникаций.

Столешница — одна деталь из AISI 304; по периметру гнётся отбортовка. Установка на опорные полки — без болтов; посадку и зацепление уточнить по контрольному образцу перед серийным раскроем.

ЗОНА ВЫДАЧИ — ЭЛЕМЕНТ 6 | перфорированный лоток-каплеуловитель

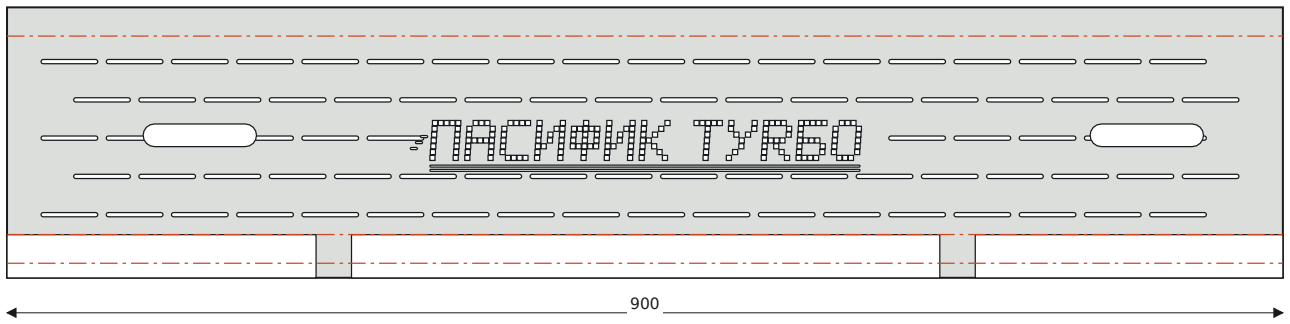
[picture p11: figure]
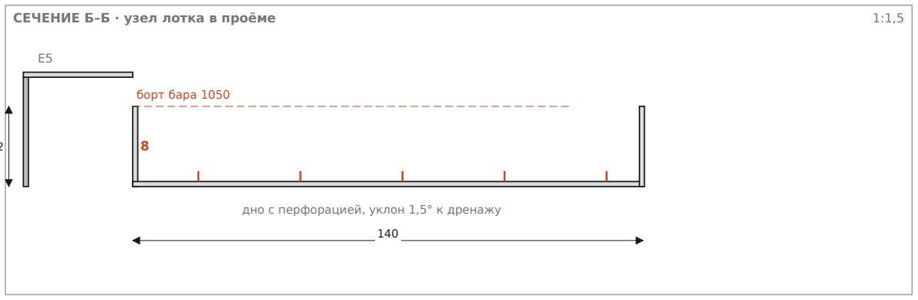
[picture p12: figure]
СЕЧЕНИЕ Б–Б · узел лотка в проёме; борт бара 1050; дно с перфорацией, уклон 1,5° к дренажу

ПАСИФИК КИТ · PK-900 · альбом проекта и комплект DXF · размеры в мм · материал AISI 304 | лист 7 / 14 масштаб 1:4 / 1:1,5 / 1:1

191

развёртка 1:5 · 900 × 191
полосы: крюк 12 / стенка 22 / дно 140 / стенка 22

900

140 | ЛОТОК · ПЛАН 1:5 | перфорация 40 × 3 + логотип
| | 5 рядов, смещение через ряд

22

УЗЕЛ 6-А · крюк в паз | 1:1

язык лотка 25 × 12

паз 26 × 11 в отбортовке столешницы

СОСТАВ УЗЛА 6

Поз. | Деталь | Материал | Кол.
6 | Корпус лотка (гибка) | AISI 304, 1,0 | 1
— | Дренажный фитинг (по месту) | уточнить | 1
6.2 | Шланг Ø16 × 600 | ПВХ пищевой | 1
6.3 | Канистра 3 л | ПЭ | 1

Лоток выкраивается цельной заготовкой и формуется отбортовками. Сборочной сварки нет. Сквозная перфорация формирует логотип «ПАСИФИК ТУРБО»; сток и уклон согласовать с выбранной ёмкостью до серийной резки.

ВАРИАНТЫ ИСПОЛНЕНИЯ
Базовый — как на листе: съёмный лоток, дренаж в канистру. Для стационарной версии — лоток приварен к столешнице, дренаж в сифон. Для улицы без воды — сухой лоток с гравийной кассетой (вкладыш 20 мм) вместо шланга.

ПРИМЕЧАНИЯ

1. Лоток съёмный: два пальцевых выреза 80 × 16, без инструмента, моется в посудомоечной машине.
2. Борт лотка — верхняя плоскость бара 1050; рабочая поверхность столешницы опущена до 850 (−200 мм, уровень бедра), вертикальный фартук закрывает перепад.
3. Перфорация лазерная, смещение через ряд — самоочищающаяся решётка.
4. Дренаж — в правом торце, шланг уходит внутрь стойки в канистру 3 л (карман F4).
5. В сборе лоток работает распоркой: снимать его при поднятой столешнице нельзя.

## ФАСАДНЫЕ БЛОКИ — ЭЛЕМЕНТЫ 3, 4, 5 три блока 900 × 334

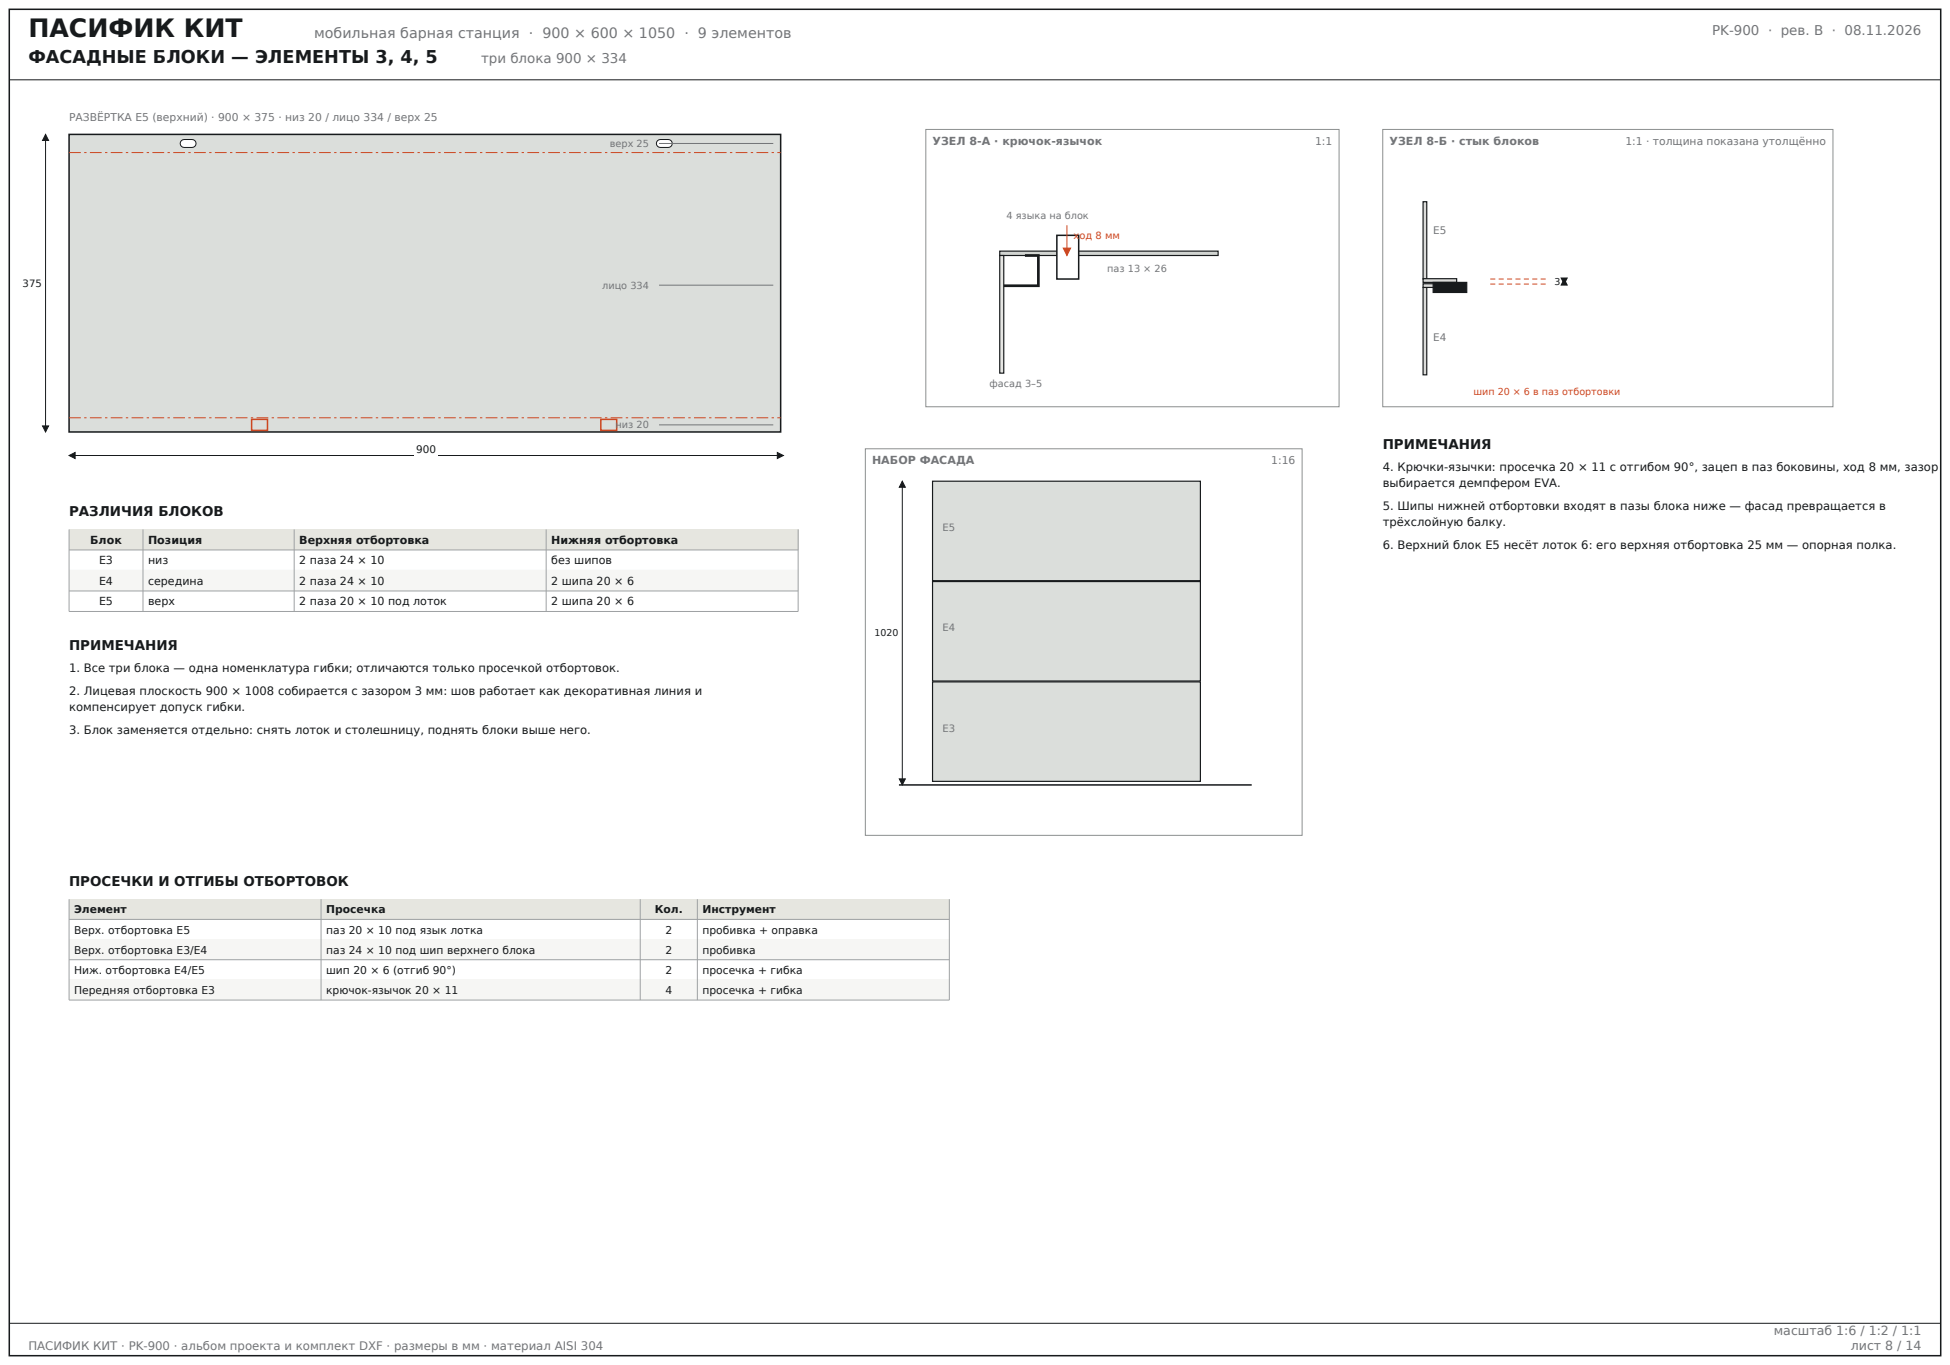
[picture p13: page 8]
ПАСИФИК КИТ · PK-900 · альбом проекта и комплект DXF · размеры в мм · материал AISI 304; лист 8 / 14; масштаб 1:6 / 1:2 / 1:1; низ 20; лицо 334; верх 25; УЗЕЛ 8-А · крючок-язычок; ход 8 мм; фасад 3–5; паз 13 × 26; УЗЕЛ 8-Б · стык блоков; 1:1 · толщина показана утолщённо; РАЗЛИЧИЯ БЛОКОВ; Блок; Позиция; Верхняя отбортовка; Нижняя отбортовка; НАБОР ФАСАДА; ПРИМЕЧАНИЯ; Элемент; Просечка; Кол.; Инструмент

РАЗВЁРТКА E5 (верхний) · 900 × 375 · низ 20 / лицо 334 / верх 25

4 языка на блок

шип 20 × 6 в паз отбортовки

4. Крючки-язычки: просечка 20 × 11 с отгибом 90°, зацеп в паз боковины, ход 8 мм, зазор
выбирается демпфером EVA.

5. Шипы нижней отбортовки входят в пазы блока ниже — фасад превращается в
трёхслойную балку.

6. Верхний блок E5 несёт лоток 6: его верхняя отбортовка 25 мм — опорная полка.

E3 | низ | 2 паза 24 × 10 | без шипов
E4 | середина | 2 паза 24 × 10 | 2 шипа 20 × 6
E5 | верх | 2 паза 20 × 10 под лоток | 2 шипа 20 × 6

1. Все три блока — одна номенклатура гибки; отличаются только просечкой отбортовок.

2. Лицевая плоскость 900 × 1008 собирается с зазором 3 мм: шов работает как декоративная линия и
компенсирует допуск гибки.

3. Блок заменяется отдельно: снять лоток и столешницу, поднять блоки выше него.

ПРОСЕЧКИ И ОТГИБЫ ОТБОРТОВОК

Верх. отбортовка E5 | паз 20 × 10 под язык лотка | 2 | пробивка + оправка
Верх. отбортовка E3/E4 | паз 24 × 10 под шип верхнего блока | 2 | пробивка
Ниж. отбортовка E4/E5 | шип 20 × 6 (отгиб 90°) | 2 | просечка + гибка
Передняя отбортовка E3 | крючок-язычок 20 × 11 | 4 | просечка + гибка

## БОКОВЫЕ СТЕНКИ — ЭЛЕМЕНТЫ 1, 2 несущие панели с пазами

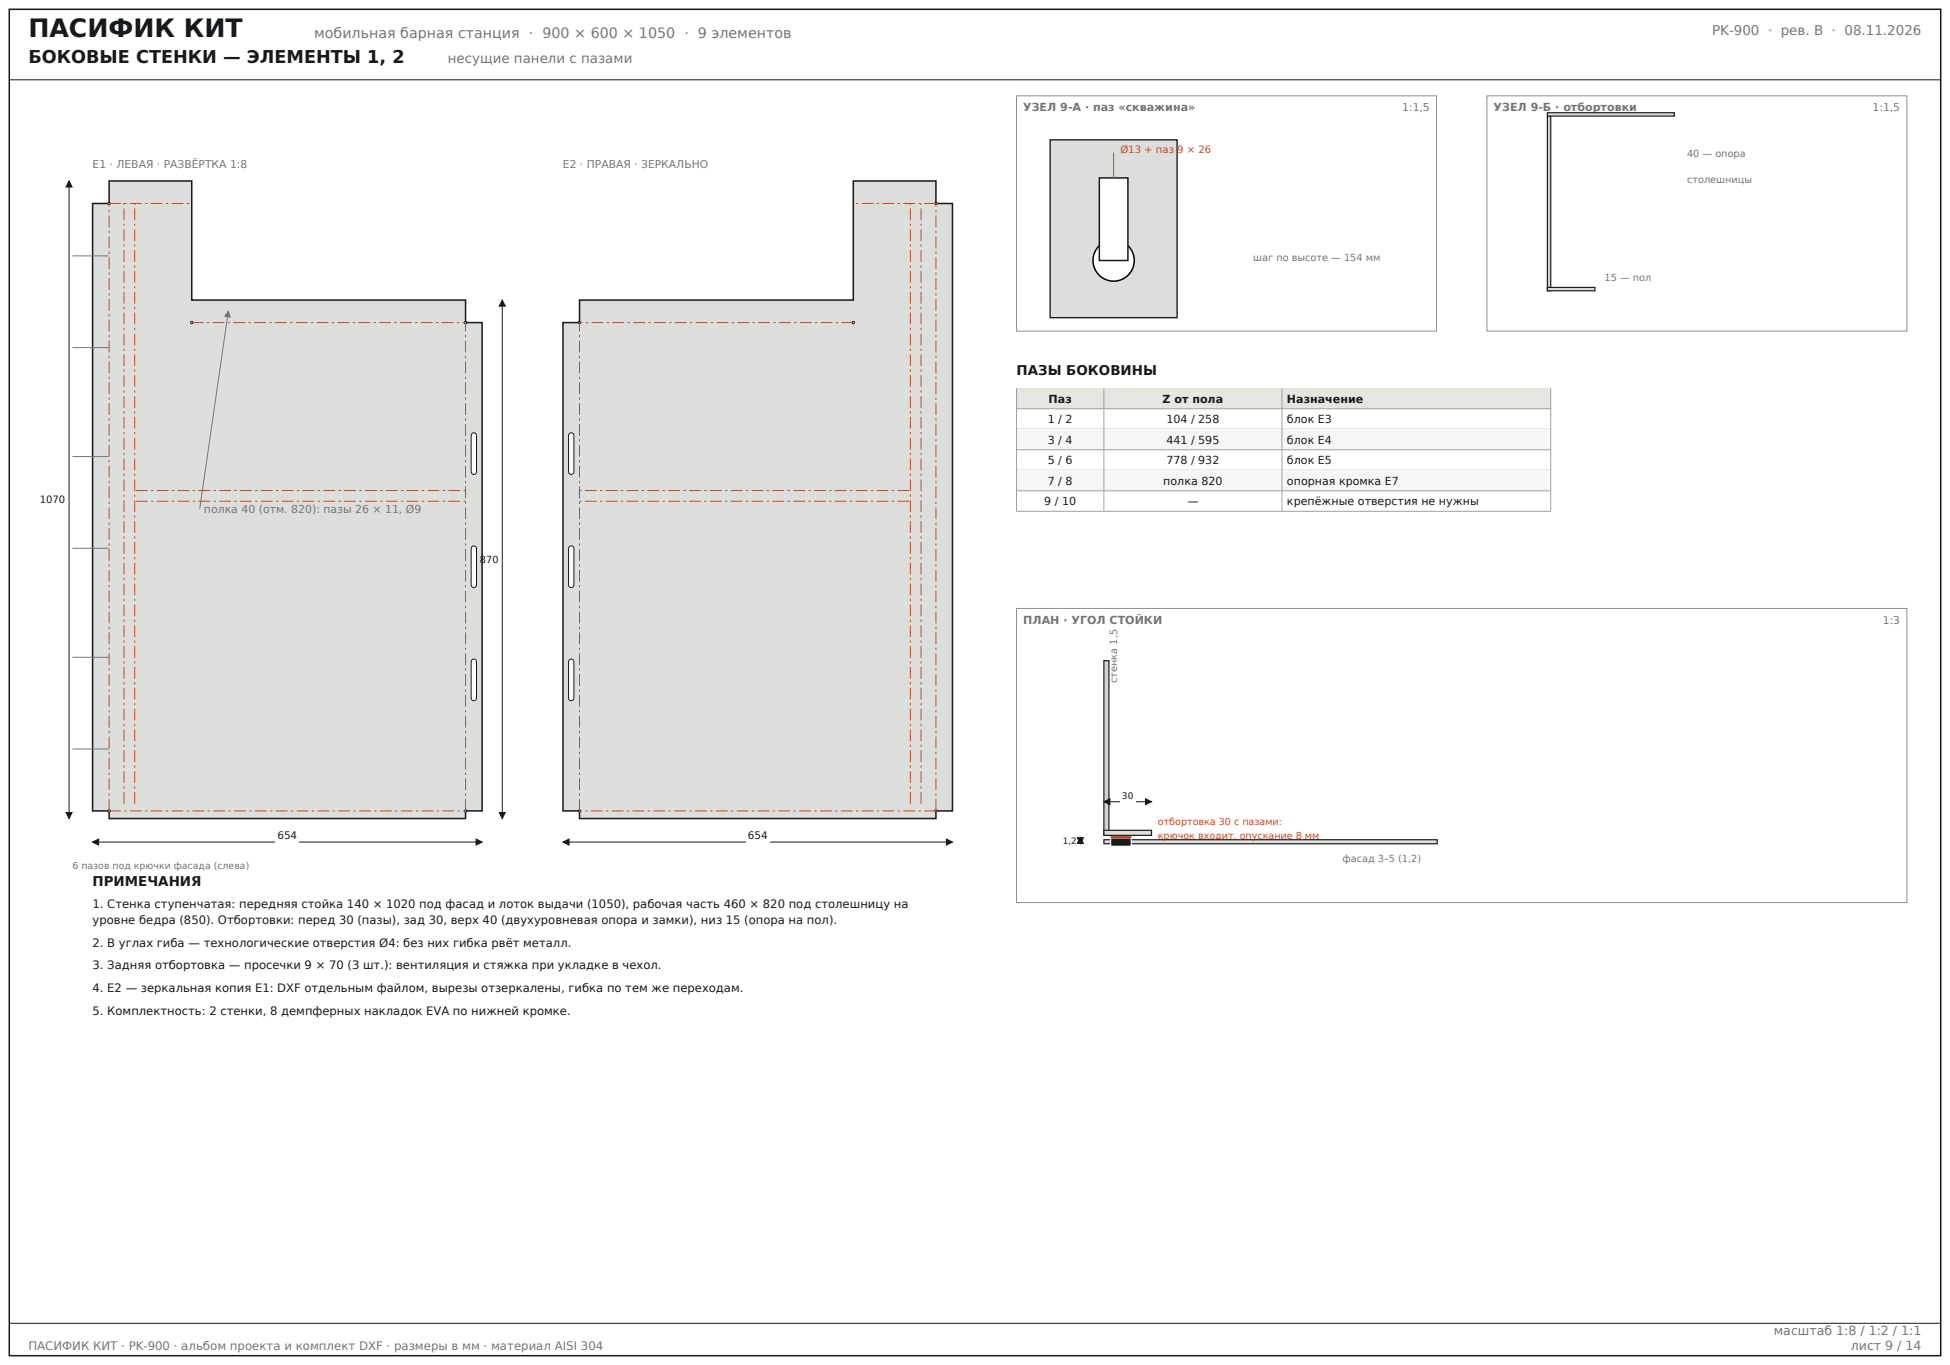
[picture p14: page 9]
ПАСИФИК КИТ · PK-900 · альбом проекта и комплект DXF · размеры в мм · материал AISI 304; лист 9 / 14; масштаб 1:8 / 1:2 / 1:1; E1 · ЛЕВАЯ · РАЗВЁРТКА 1:8; E2 · ПРАВАЯ · ЗЕРКАЛЬНО; УЗЕЛ 9-А · паз «скважина»; Ø13 + паз 9 × 26; УЗЕЛ 9-Б · отбортовки; 40 — опора; столешницы; 15 — пол; ПАЗЫ БОКОВИНЫ; Паз; Z от пола; Назначение; ПЛАН · УГОЛ СТОЙКИ; фасад 3–5 (1,2); стенка 1,5; отбортовка 30 с пазами:

шаг по высоте — 154 мм

1 / 2 | 104 / 258 | блок E3
3 / 4 | 441 / 595 | блок E4
5 / 6 | 778 / 932 | блок E5
7 / 8 | полка 820 | опорная кромка E7
9 / 10 | — | крепёжные отверстия не нужны

полка 40 (отм. 820): пазы 26 × 11, Ø9

крючок входит, опускание 8 мм 1,2

6 пазов под крючки фасада (слева)
ПРИМЕЧАНИЯ

1. Стенка ступенчатая: передняя стойка 140 × 1020 под фасад и лоток выдачи (1050), рабочая часть 460 × 820 под столешницу на
уровне бедра (850). Отбортовки: перед 30 (пазы), зад 30, верх 40 (двухуровневая опора и замки), низ 15 (опора на пол).

2. В углах гиба — технологические отверстия Ø4: без них гибка рвёт металл.

3. Задняя отбортовка — просечки 9 × 70 (3 шт.): вентиляция и стяжка при укладке в чехол.

4. E2 — зеркальная копия E1: DXF отдельным файлом, вырезы отзеркалены, гибка по тем же переходам.

5. Комплектность: 2 стенки, 8 демпферных накладок EVA по нижней кромке.

УЗЛЫ | соединения · фиксация · монтаж оборудования
ПАСИФИК КИТ · PK-900 · альбом проекта и комплект DXF · размеры в мм · материал AISI 304 | лист 10 / 14 масштаб 1:1 / 1:2
УЗЕЛ 1 · столешница — стенка | 1:1

взаимный зацеп

отбортовка 40 / опора

- Отбортовка стенки 40 мм — опорная полка.
- Гнутые направляющие кромки входят в зацепление без крепёжных деталей.
- Посадка скользящая, без болтов и винтов.
- Люфт после фиксации — не более 1 мм.
УЗЕЛ 2 · фасад — стенка | 1:1

крючок → паз

ход 8 мм

- Крючок-язычок 20 × 11 заходит в паз «скважину».
- Опускание на 8 мм — рабочее положение.
- 4 крючка на блок: 2 слева, 2 справа.
- Демпфер EVA убирает дребезг.
УЗЕЛ 3 · блок — блок | 1:2

зазор 3

- Шип 20 × 6 нижней отбортовки — в паз верхней.
- Зазор 3 ±0,5 мм — монтажный и декоративный.
- Три блока = балка 1008 мм с двумя зазорами.
- Сборка снизу вверх, разборка сверху вниз.
УЗЕЛ 4 · лоток — столешница | 1:2

язык в паз

- 2 языка 25 × 12 входят в пазы 26 × 11.
- Опора — отбортовка верхнего блока E5.
- Кромка лотка на 8 мм ниже столешницы.
- Съём без инструмента за пальцевые вырезы.
УЗЕЛ 5 · опора-клин | 1:2

клин 0…12 мм

- Клин 0–12 мм под нижнюю отбортовку.
- 4 точки: 2 на стенку, у передней и задней кромки.
- Выравнивание по уровню на неровной площадке.
- Хранится в кармане чехла (F3).
УЗЕЛ 6 · раковина и гастроёмкости | 1:2

GN 1/2 (мойка)
- Отверстие 300 × 240 R12 под опорную рамку съёмной GN 1/2.
- 4 отсека 90 × 160 R8 под гастроёмкости GN 1/9 (борт 9 мм).
- Проверить посадку и слив выбранной гастроёмкости.

Общий принцип: соединения без крепежа — «крючок + паз», шипы блоков и скользящая посадка на гнутые опорные полки. Столешницу и лоток установить без болтов; усилие скольжения и допуски проверить на контрольном образце. Демпфер EVA снижает дребезг.

### СПЕЦИФИКАЦИЯ КРЕПЕЖА

Код | Соединение / вспомогательная детальРазмер | Кол. | Где
— | Крючок + ключевой паз (интегральные) | 20 × 11 по геометриифасад — стенка
— | Шип + ответный паз (интегральные) | 20 × 6 по геометрииблок — блок
— | Гнутые опорные полки | 820 мм | 2 | стенка — столешница
— | Опора-клин регулируемая | 0–12 мм | 4 | низ стенок, на пол
— | Накладка демпферная | EVA | 8 | нижняя кромка стенок

### ЧТО НУЖНО ОСВОИТЬ ПРОИЗВОДСТВУ

Две просечки: «крючок-язычок» 20 × 11 с отгибом и паз-«скважина» Ø13 + 9 × 26. Обе выполняются на лазере с последующей гибкой на пресс-листе — специальной оснастки не требуется, достаточно двух программ и упора.

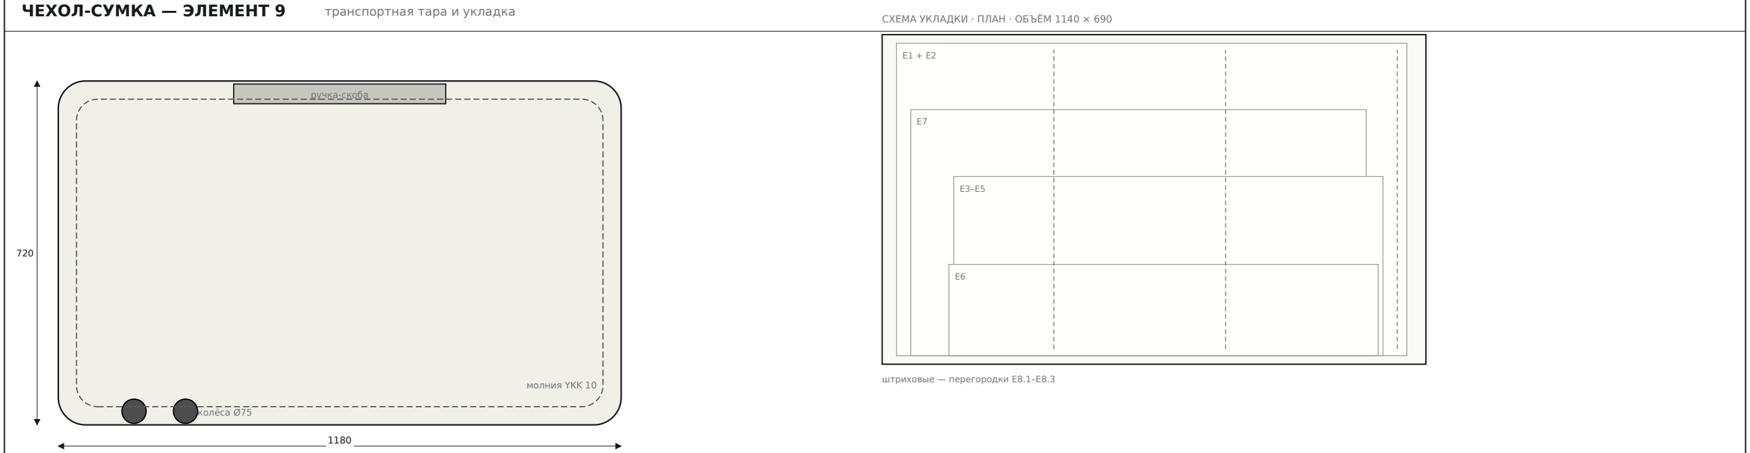
[picture p15: figure]
ЧЕХОЛ-СУМКА — ЭЛЕМЕНТ 9; транспортная тара и укладка; ручка-скоба; колёса Ø75; молния YKK 10; СХЕМА УКЛАДКИ · ПЛАН · ОБЪЁМ 1140 × 690; штриховые — перегородки E8.1–E8.3

ПАСИФИК КИТ · PK-900 · альбом проекта и комплект DXF · размеры в мм · материал AISI 304 | лист 11 / 14 масштаб 1:9

ЧЕХОЛ · ПЛАН 1:9 · высота 145

720

145

ВИД С ТОРЦА 1:9

СТЕК СЛОЁВ ПО ТОЛЩИНЕ (без масштаба)

E6 · лоток 22 мм

E7 · столешница 30

E3–E5 · 3 × 1,2

E1 + E2 · 2 × 1,5

перегородки + демпфер

≈ 100

внутренняя высота чехла 110 мм — запас 10 мм

### КОНСТРУКЦИЯ ЧЕХЛА

Слой | Материал | Назначение
1 | PES 1680D, PVC | внешняя оболочка, грязе- и водоотталкивающая
2 | EVA 10 мм | демпфер, защита кромок металла
3 | HDPE 3 мм (E8.1–E8.3) | жёсткие перегородки между пакетами
4 | Фурнитура | колёса Ø75 (2 шт.), ручка-скоба, 2 лямки
5 | Молния YKK 10 | по трём сторонам, два бегунка
6 | Карманы | паспорт, схема укладки и демпферы

Чехол — мягкий кейс с жёстким дном и тремя HDPE-перегородками: детали укладываются «сэндвичем» и не касаются друг друга кромками. В вертикальном положении стоит на колёсах, тяжёлые стенки — у колёсной стороны: центр масс ниже оси ручки. 1180 × 720 × 145 проходит в багажник универсала или кроссовера.

ПРИМЕЧАНИЯ

Масса комплекта металла: около 30,0 кг (без оборудования и без чехла).

Вариант «лайт»: стенки 1,2 мм и фасад 1,0 мм — минус 5,0 кг, сборка та же.

Опция: два колёса + телескопическая ручка (как у дорожной сумки).

В кузове — 4 стяжные лямки через внешние кольца (опция).

ПОРЯДОК СБОРКИ И РАЗБОРКИ | 8 шагов · 5–7 минут вдвоём
ПАСИФИК КИТ · PK-900 · альбом проекта и комплект DXF · размеры в мм · материал AISI 304 | лист 12 / 14

изометрия без масштаба

1 · стенки 1 и 2 | 2 · блок E3 | 3 · блок E4 | 4 · блок E5 | 5 · столешница E7 | 6 · лоток E6
Шаг | Действие | Время | Проверка
0 | Расстелить чехол, вынуть детали в порядке укладки (сверху вниз) | 1 мин | комплектность по паспорту
1 | Поставить стенки 1 и 2 на пол отбортовками внутрь, база 900 мм (шаблон-шнур), выставить клинья F3 | 1,5 мин | диагонали ±2 мм
2 | Вставить блок E3 в пазы отбортовок, опустить на 8 мм до упора | 0,5 мин | зазор 3 мм, люфта нет
3 | Блок E4 — шипы в пазы E3, опустить | 0,5 мин | шов ровный
4 | Блок E5 — то же; верхняя отбортовка 25 мм — полка под лоток | 0,5 мин | верхняя кромка 1020
5 | Столешница E7 направить в полки 820, скользяще опустить до упора (рабочая плоскость 850) | 1 мин | люфт ≤ 1 мм
6 | Лоток E6: языки в пазы, опустить, шланг в канистру | 0,5 мин | уклон к дренажу
7 | Оборудование: ёмкости GN 1/9, большая GN 1/2 как мойка | 1,5 мин | пролив воды
8 | Разборка — в обратном порядке, детали протереть, уложить по схеме листа 11 | 4 мин | кромки без влаги

ПРИМЕЧАНИЯ

Стойка собирается без единого болта: панели зацепляются встроенными крючками и пазами, столешница скользяще садится на опорные полки.

Порядок нарушать нельзя: фасад собирается снизу вверх, разбирается сверху вниз, лоток снимается первым.

Смазка пазов — раз в сезон, силиконовая, без масла (пищевое производство).

ПРИМЕЧАНИЯ

После мойки: протереть, просушить, не закрывать чехол влажным.

Перед эксплуатацией проверять фиксацию интегральных зацепов, свободный ход и состояние демпферов EVA.

При перевозке в собранном виде станцию не кантовать: нагрузка на узлы не расчётная.

Демонтаж занимает 4 минуты — вдвое быстрее сборки: детали просто снимаются.

ПРОИЗВОДСТВО И КОМПЛЕКТ DXF | раскрой · гибка · безболтовая сборка · контроль
ПАСИФИК КИТ · PK-900 · альбом проекта и комплект DXF · размеры в мм · материал AISI 304 | лист 13 / 14

E1

E2

E7 ↻

E9

S1 · 1,2 мм · 1250 × 2500

масштаб 1:30

E3

E4

E5

S2 · 1,2 мм · 1250 × 1200

масштаб 1:30

E6

S3 · 1,0 мм · 1000 × 500

масштаб 1:30

### РАСКРОЙ

Три листа, 11 деталей (8 металлических узлов и 3 HDPE перегородки). Раскладка в DXF (PK-NEST_all_sheets.dxf) — для проверки; финальную раскладку цех делает под свой лист. E7 разворачивается на 90° и укладывается между стенками.

### ГИБКА

Последовательность: сначала длинные отбортовки (стенки — верх 40, затем перед/зад 30, затем низ 15), затем короткие. Столешница: 4 стороны по контуру, после гибки — правка на плите. Фасадные блоки: верх 25 и низ 20, крючки-язычки отгибаются после резки. R1,0 (t 1,5) и R0,8 (t 1,2/1,0). Угол 90° ±0,5°.

### СВАРКА И ФИНИШ

Сварка стойки не применяется. Лоток E6 — одна заготовка с отбортовками; гидравлический фитинг (если понадобится) отдельный и не участвует в сборке корпуса. Финиш — матирование вдоль проката Scotch-Brite 240, обезжиривание, плёнка на лицевые поверхности.

### КОМПЛЕКТ DXF

Файл | Деталь | t | Развёртка
PK-E1.dxf | Стенка боковая левая | 1,5 | 654 × 1070
PK-E2.dxf | Стенка боковая правая | 1,5 | 654 × 1070
PK-E3.dxf | Фасадный блок нижний | 1,2 | 900 × 375
PK-E4.dxf | Фасадный блок средний | 1,2 | 900 × 375
PK-E5.dxf | Фасадный блок верхний | 1,2 | 900 × 375
PK-E6.dxf | Лоток зоны выдачи | 1,0 | 900 × 191
PK-E7.dxf | Столешница с вырезами | 1,5 | 955 × 515
PK-E9.dxf | Перегородка внутренняя | 1,5 | 540 × 887
PK-E8.x.dxf | Перегородки чехла (3) | 3,0 HDPE | 640 × 240
PK-NEST.dxf | Раскрой, 3 листа | — | 1250 × 2500

### КОНТРОЛЬ

1) Размеры развёрток — по DXF, выборочно ±0,5 мм. 2) Углы 90° ±0,5°, полки ±0,5 мм. 3) Контрольная сборка на стенде: диагонали фасада ±2 мм, зазоры 3 ±0,5 мм, люфт столешницы ≤ 1 мм при 60 кг. 4) Герметичность лотка — пролив 2 л. 5) Заусенец и острые кромки — визуально и на ощупь, кромки вырезов R1,5.

### СОСТАВ ПОСТАВКИ

8 металлических деталей из AISI 304 (в том числе внутренняя перегородка) с интегральными безболтовыми зацепами, демпферы, клинья, чехол-сумка и паспорт. Оборудование не входит: 4 малые гастроёмкости и одна большая гастроёмкость GN 1/2 как мойка подбираются по месту. Кран не входит в комплект.

ПРИМЕЧАНИЯ

Материал принимать по сертификату: AISI 304, толщина с допуском ±0,05 мм, шлифовка 240. Листы хранить в плёнке, резку вести на защитной подложке, чтобы не тянуть царапины по лицевой стороне.

Перед гибкой — снять плёнку с зоны гиба: иначе плёнка «закусывается» и остаётся в радиусе. После гибки — контроль плоскости на плите, правка киянкой с прокладкой.

### ПЕРВЫЙ ОБРАЗЕЦ — ЧТО ПРОВЕРИТЬ НА СБОРКЕ

Собрать один комплект и проверить: 1) диагонали фасада (допуск ±2 мм); 2) зазоры между блоками 3 ±0,5 мм по всей длине; 3) люфт столешницы при 60 кг — не более 1 мм; 4) пролив лотка 2 л без протечек по швам и дренажу; 5) время сборки вдвоём — не более 6 минут; 6) укладка в чехол без усилия, молния закрывается одной рукой. По результатам — правка допусков паза и, при необходимости, шага просечки.

ЭКСПЛУАТАЦИЯ, НАГРУЗКИ, УХОД | условия, ограничения, ресурс
ПАСИФИК КИТ · PK-900 · альбом проекта и комплект DXF · размеры в мм · материал AISI 304 | лист 14 / 14

### НАГРУЗКИ И УСТОЙЧИВОСТЬ

25 + 25 + 25 кг

40 кг в точке

ФАСАД 1:12 · схема нагрузок

1050

Воздействие | Расчёт | Запас
Равномерно по столешнице | 60 кг | прогиб ≤ 3 мм
Сосредоточенная на кромке | 40 кг | прогиб ≤ 5 мм
Раковина (2 секции) + GN 1/9 | 30 кг | на вырезы и перемычки
Боковой навал на фасад | 30 кг | сдвиг ≤ 2 мм
Опрокидывание | 90 кг на кромке | коэф. ≥ 2,0
Ветер (улица, без тента) | до 10 м/с | при 15 м/с — балласт 20 кг

ПРИМЕЧАНИЯ

Станция стоит на двух отбортовках 15 мм; при неровном покрытии выставить клинья F3 и проверить диагонали. На мягком грунте/траве — подкладки 200 × 200 мм под каждую опору.

Внутренний объём 0,54 м³ — использовать для балласта (канистры 2 × 10 л), ящиков и инвентаря: масса внизу повышает устойчивость.

Не вставать на столешницу и не опираться на фасад всем весом: расчётная нагрузка — 60 кг равномерно.

При минусовых температурах не допускать попадания воды в пазы и дренаж — лёд расклинивает отбортовки.

### УХОД

Ежедневно: протереть водным раствором ПАВ, промыть лоток, просушить. Не применять хлорсодержащие и абразивные средства, металлические губки, кислотные очистители — они разрушают пассивный слой AISI 304. Раз в сезон — смазка пазов силиконом, проверка интегральных зацепов и клиньев.

### ОГРАНИЧЕНИЯ

Станция негерметична: раковина без крана заполняется и сливается через выносную канистру или приямок, вода не должна литься на пол под стойкой. Не использовать как место для горячих поверхностей без подкладки. Не эксплуатировать при ветре свыше 15 м/с без балласта и тента.

### ОПЦИИ

Вариант | Изменение | Влияние
Лайт | стенки 1,2 / фасад 1,0 | −5,5 кг
Брендинг | сменный блок E5 с логотипом | без замены станции
Колёсная база | съёмная платформа на 4 колеса Ø75 | +4,5 кг, 1 мин
Мойка / лёд | дополнительная большая гастроёмкость | изменить рабочий вырез по рамке
Чехол-тележка | колесо + телескопическая ручка | +1,8 кг
Закрытый тыл | доп. панель 900 × 1008 (9-й элемент) | +3,2 кг

### ЧТО ДАЛЬШЕ

Проект закрыт на уровне «можно отдавать в производство»: параметрическая модель, развёртки всех деталей в DXF 1:1, схема раскроя, узлы, крепёж, весовые и нагрузочные расчёты, схема укладки в чехол и порядок сборки. Дальше — изготовить оснастку для двух просечек (крючок-язычок и паз-«скважина»), собрать контрольный образец и проверить его на площадке: 20 циклов сборка-разборка и одна перевозка в багажнике.
