horaanlika-droid/pacific/docs/popup/PK-POP-900_otverstiya.png

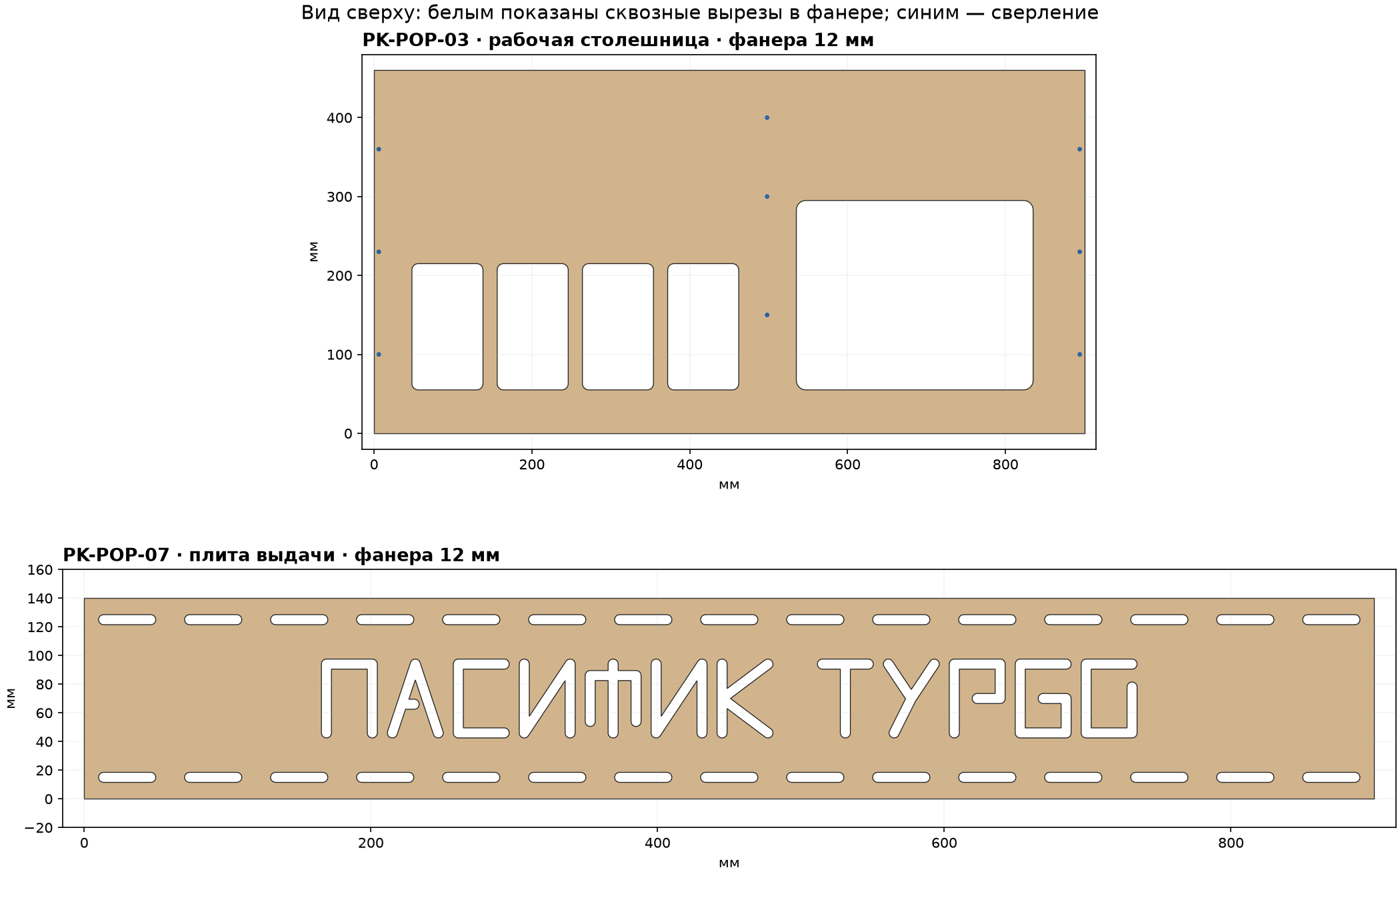
docs/popup/PK-POP-900_otverstiya.png
