horaanlika-droid/pacific/docs/visualization/angles/PK-900_angle_rear-left.png

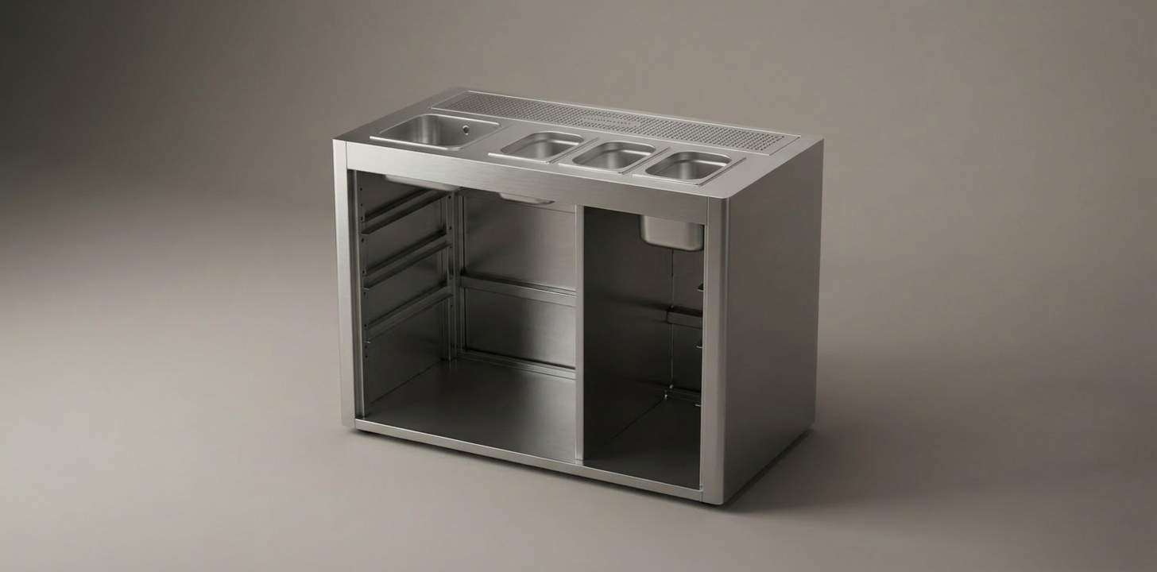
docs/visualization/angles/PK-900_angle_rear-left.png
