horaanlika-droid/pacific/docs/ПАСИФИК_КИТ_визуализация.png

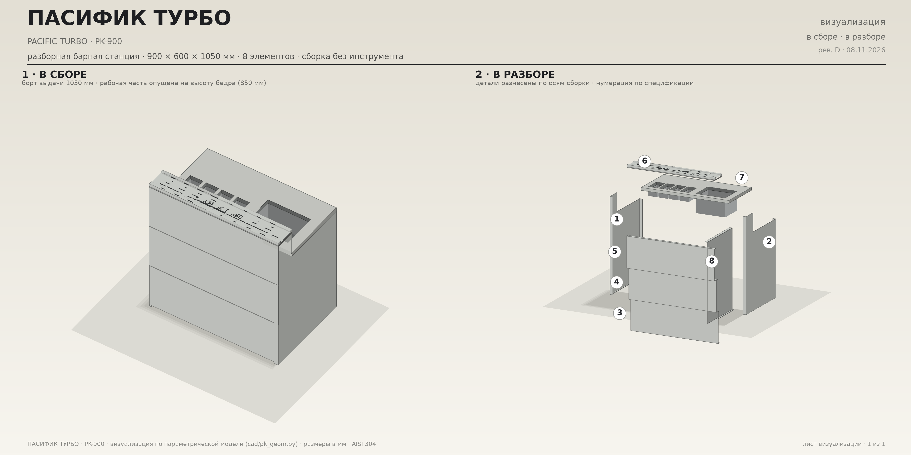
docs/ПАСИФИК_КИТ_визуализация.png
