horaanlika-droid/pacific/IMG_1840.jpeg

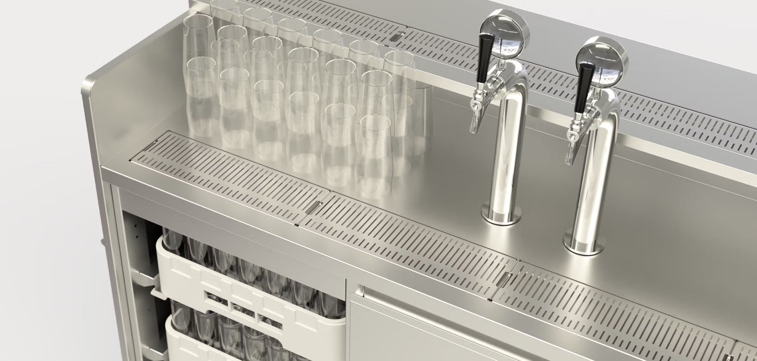
IMG_1840.jpeg
