horaanlika-droid/pacific/IMG_1842.png

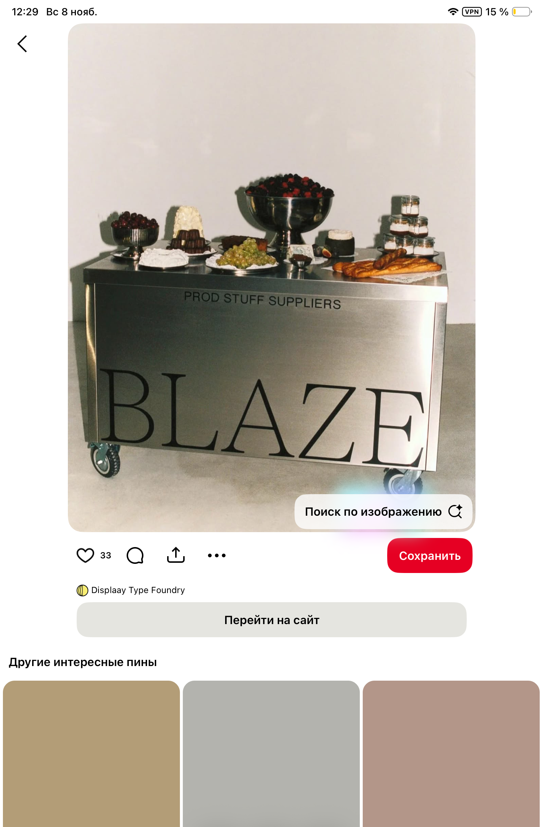
IMG_1842.png
