horaanlika-droid/pacific/IMG_1843.png

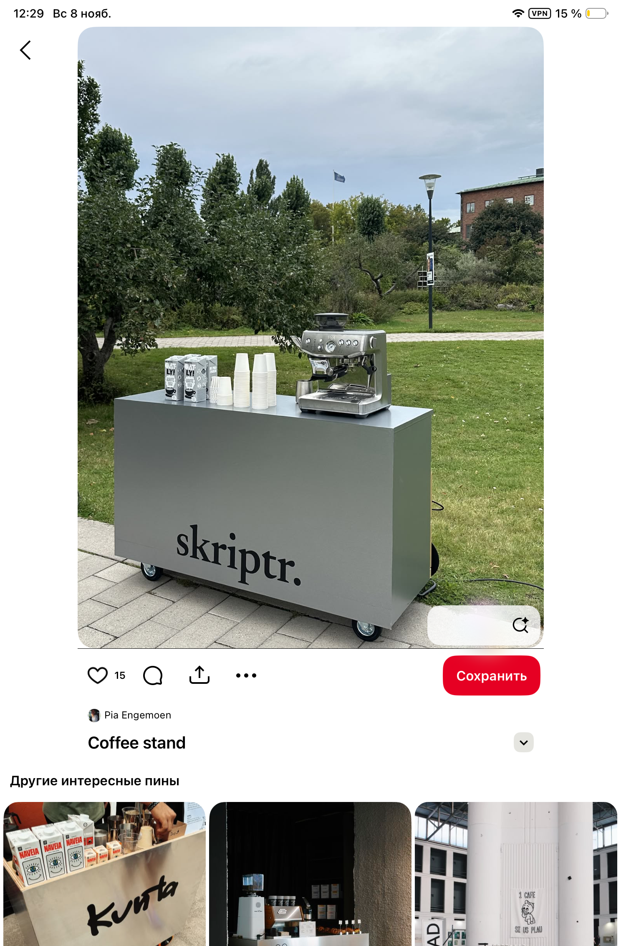
IMG_1843.png
