horaanlika-droid/pacific/IMG_1844.png

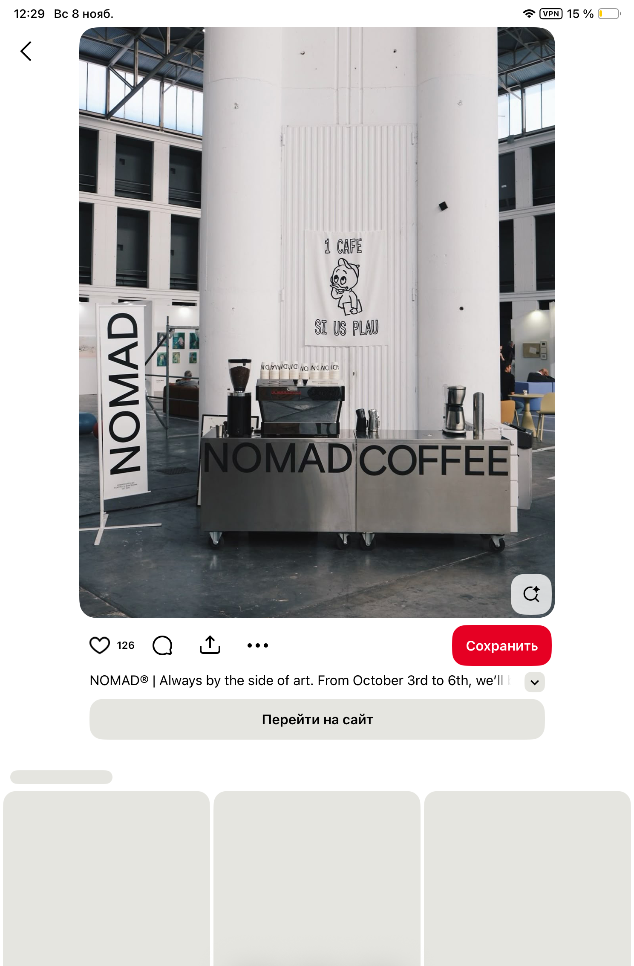
IMG_1844.png
