horaanlika-droid/pacific/docs/popup/cnc/PK-POP-07_выдача.dxf

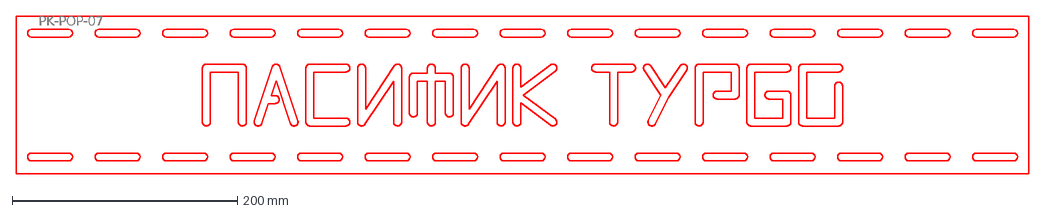
[picture p27: CAD file, 2026-11-09]
docs/popup/cnc/PK-POP-07_выдача.dxf
PK-POP-07
