horaanlika-droid/pacific/docs/popup/cnc/PK-POP-NEST_sheet1.dxf

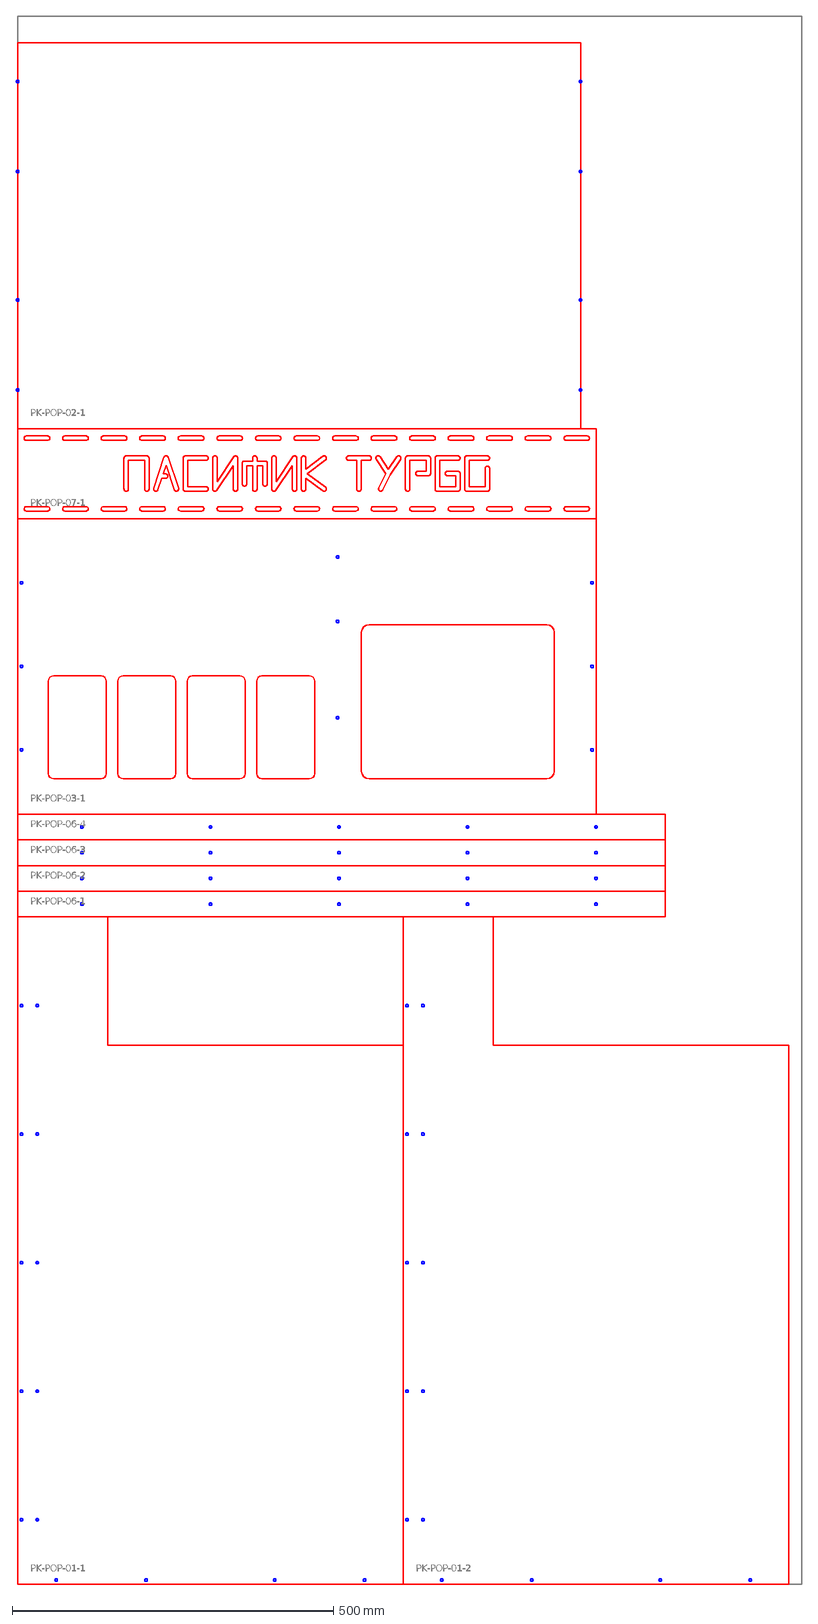
[picture p30: CAD file, 2026-11-09]
docs/popup/cnc/PK-POP-NEST_sheet1.dxf
PK-POP-01-1
PK-POP-01-2
PK-POP-06-1
PK-POP-06-2
PK-POP-06-3
PK-POP-06-4
PK-POP-03-1
PK-POP-07-1
PK-POP-02-1
