horaanlika-droid/pacific/dxf/E7_rabochaya_zona_stoleshnica_s_vyrezami.dxf

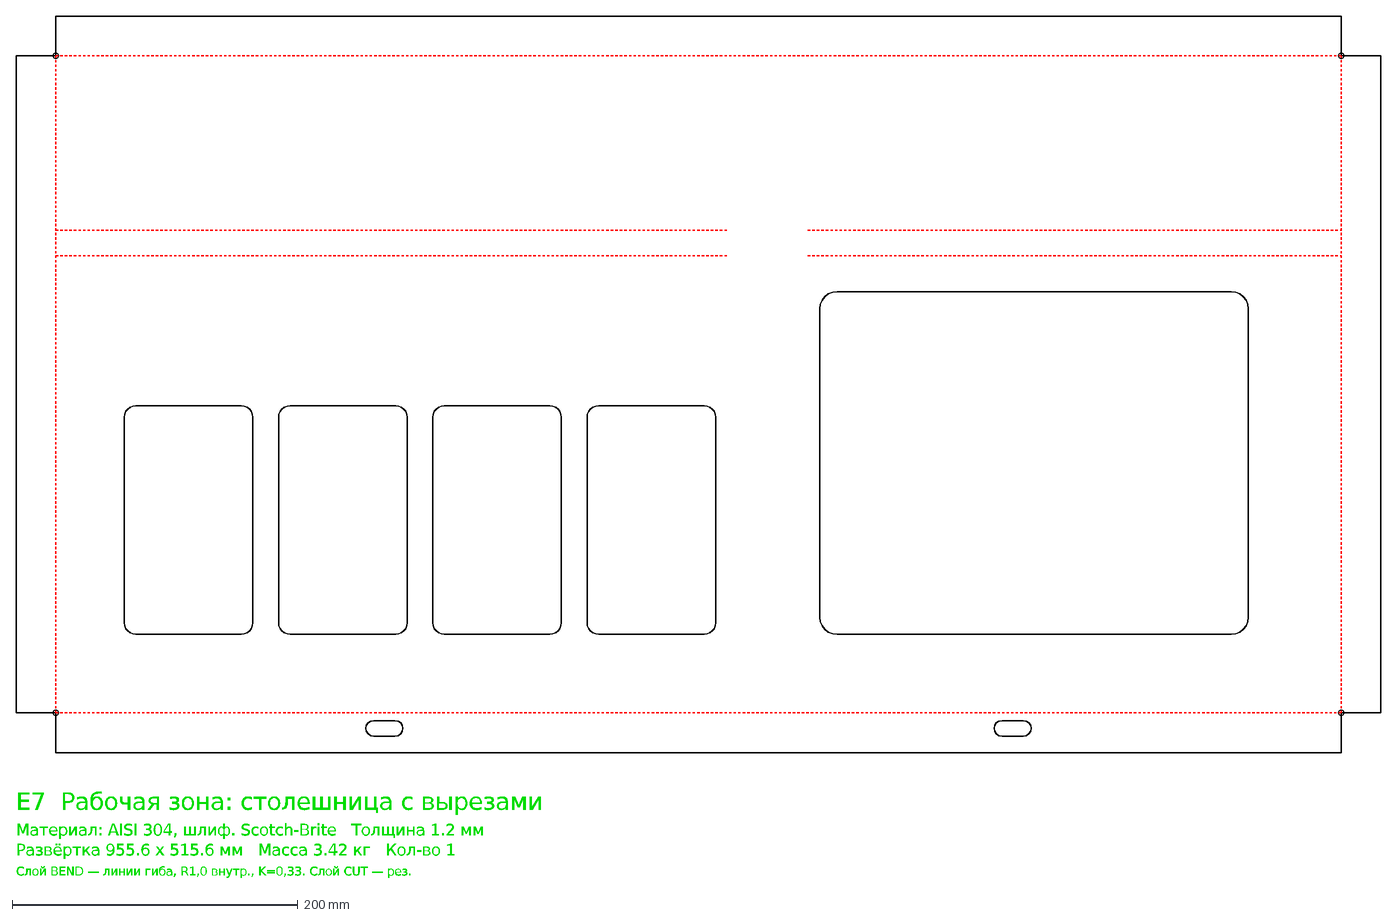
[picture p31: CAD file, 2026-11-08]
dxf/E7_rabochaya_zona_stoleshnica_s_vyrezami.dxf
E7 Рабочая зона: столешница с вырезами
Материал: AISI 304, шлиф. Scotch-Brite Толщина 1.2 мм
Развёртка 955.6 x 515.6 мм Масса 3.42 кг Кол-во 1
Слой BEND — линии гиба, R1,0 внутр., K=0,33. Слой CUT — рез.
