horaanlika-droid/pacific/docs/popup/cnc/PK-POP-01_боковина.dxf

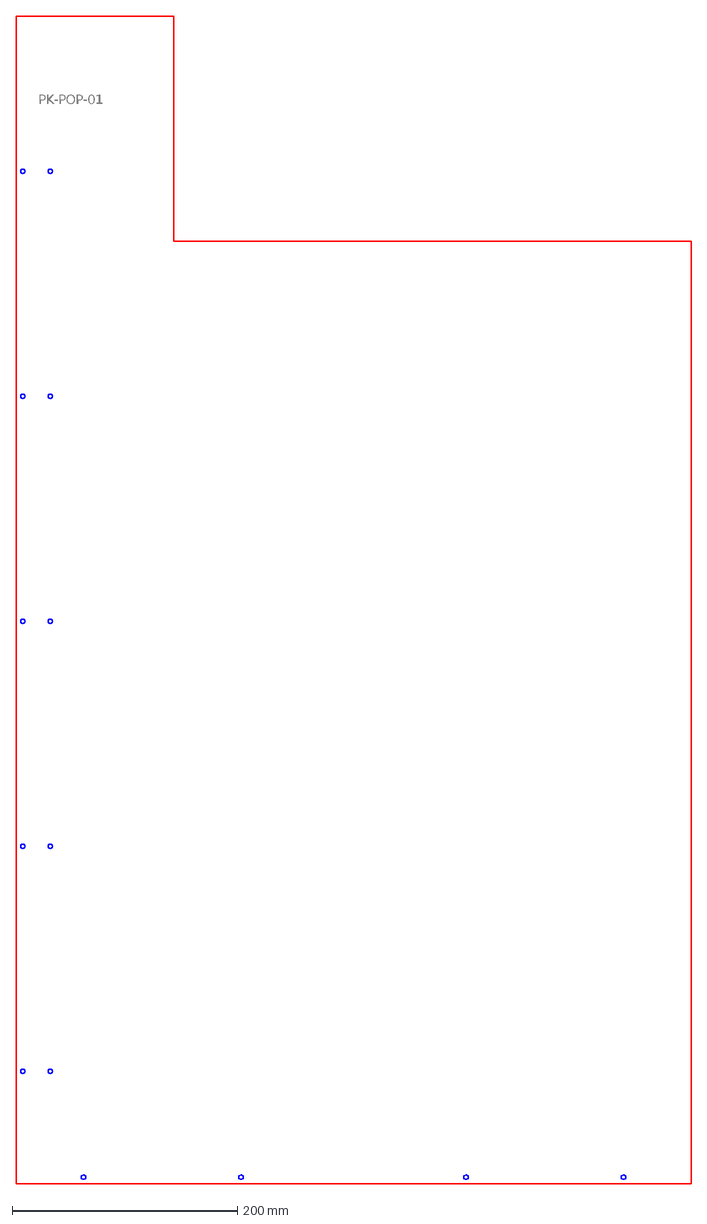
[picture p33: CAD file, 2026-11-08]
docs/popup/cnc/PK-POP-01_боковина.dxf
PK-POP-01
