horaanlika-droid/pacific/dxf/E4_fasadnyy_blok_sredniy.dxf

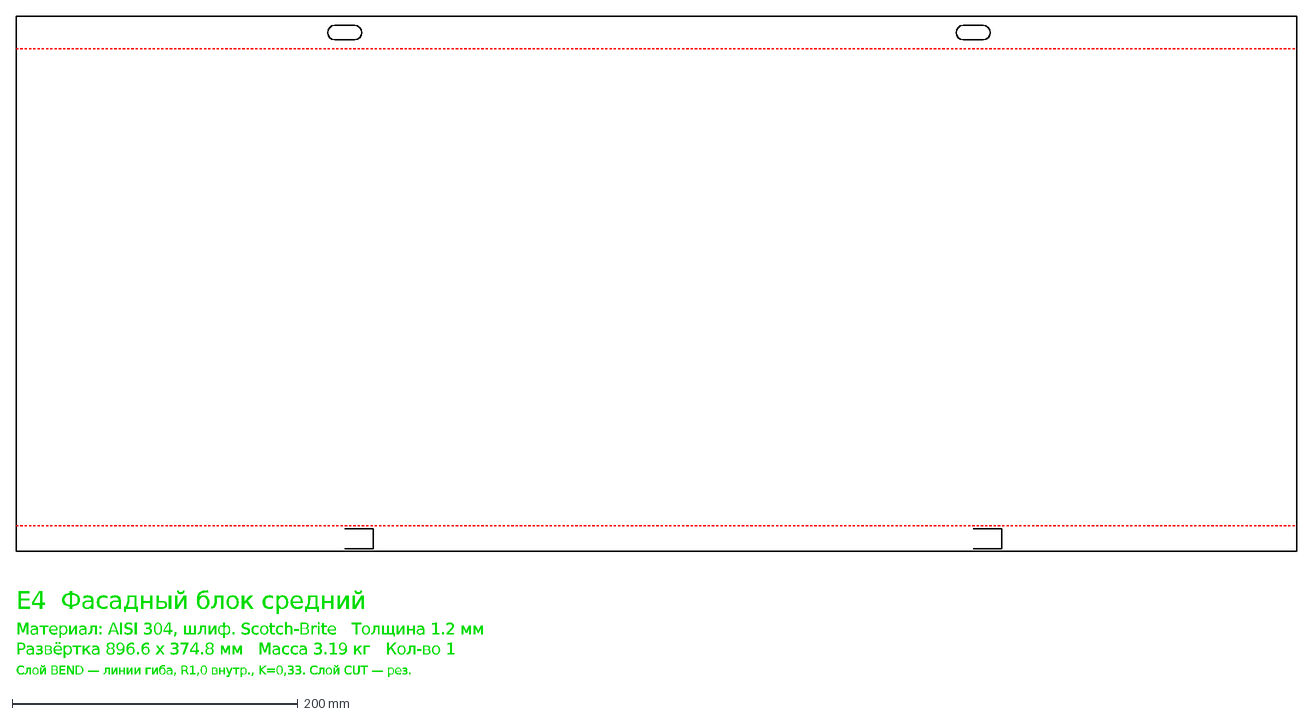
[picture p34: CAD file, 2026-11-08]
dxf/E4_fasadnyy_blok_sredniy.dxf
E4 Фасадный блок средний
Материал: AISI 304, шлиф. Scotch-Brite Толщина 1.2 мм
Развёртка 896.6 x 374.8 мм Масса 3.19 кг Кол-во 1
Слой BEND — линии гиба, R1,0 внутр., K=0,33. Слой CUT — рез.
