horaanlika-droid/pacific/docs/popup/cnc/PK-POP-06_рейка_направляющей.dxf

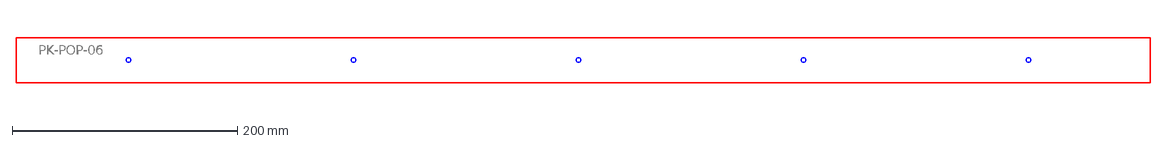
[picture p36: CAD file, 2026-11-08]
docs/popup/cnc/PK-POP-06_рейка_направляющей.dxf
PK-POP-06
