horaanlika-droid/pacific/dxf/E9_peregorodka_vnutrennyaya.dxf

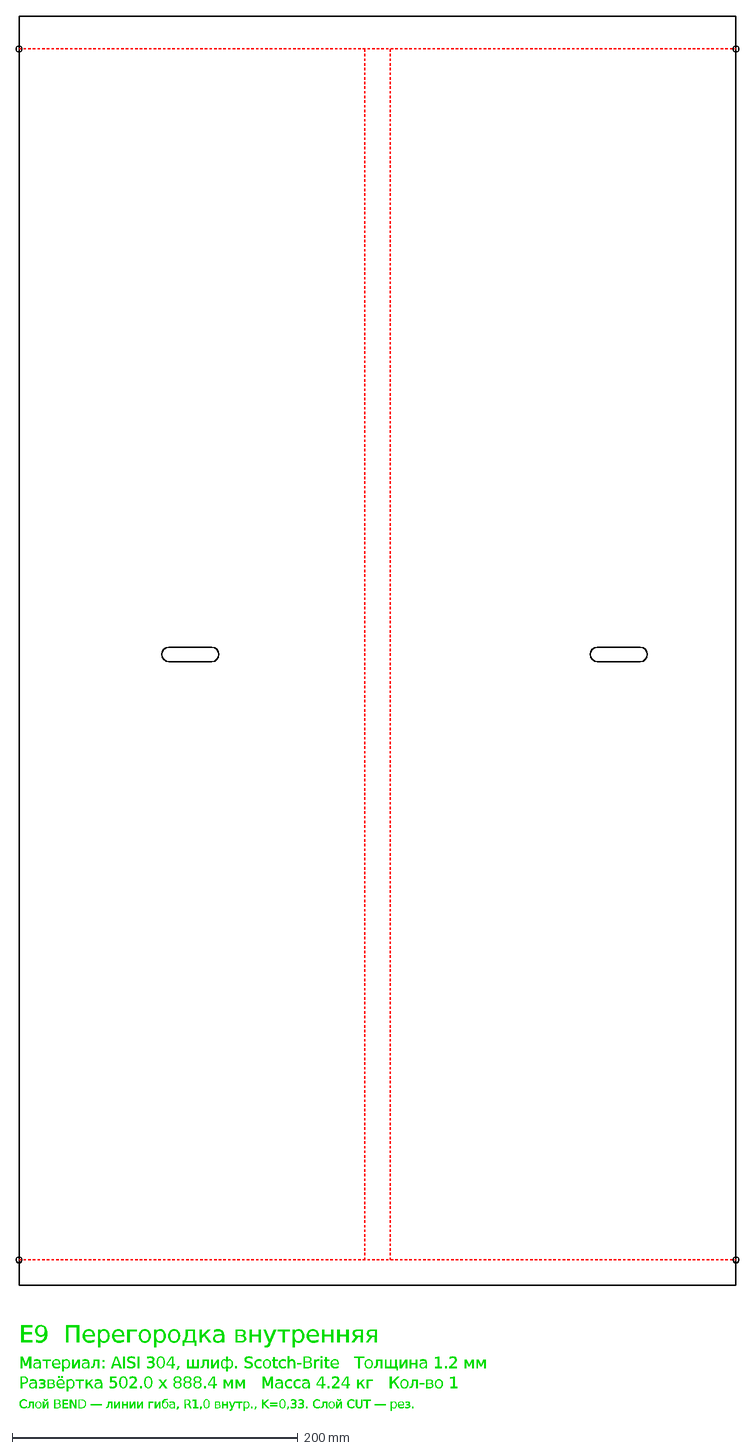
[picture p37: CAD file, 2026-11-08]
dxf/E9_peregorodka_vnutrennyaya.dxf
E9 Перегородка внутренняя
Материал: AISI 304, шлиф. Scotch-Brite Толщина 1.2 мм
Развёртка 502.0 x 888.4 мм Масса 4.24 кг Кол-во 1
Слой BEND — линии гиба, R1,0 внутр., K=0,33. Слой CUT — рез.
