horaanlika-droid/pacific/docs/popup/cnc/PK-POP-03_столешница_рабочей_зоны.dxf

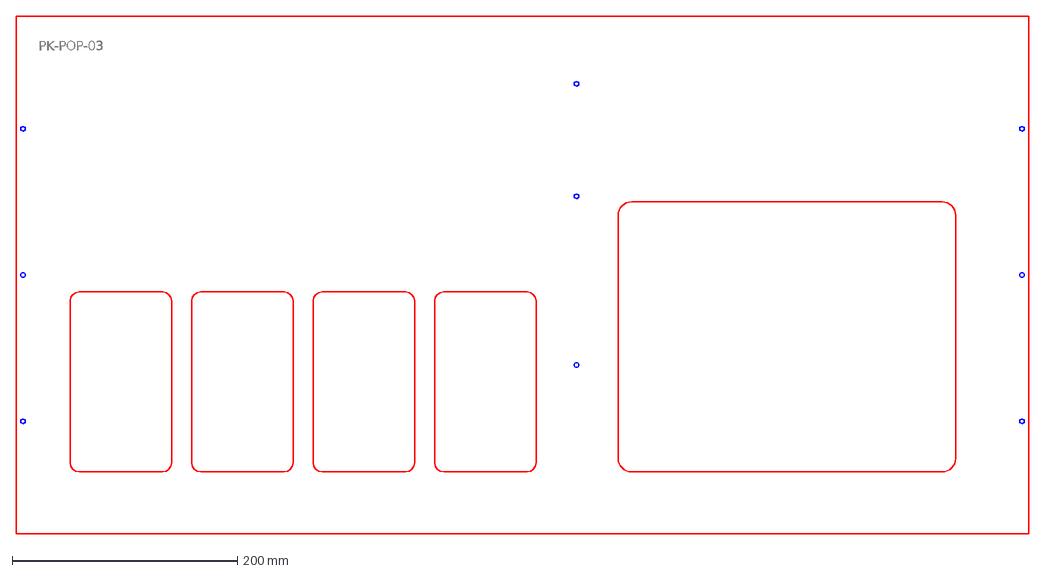
[picture p39: CAD file, 2026-11-08]
docs/popup/cnc/PK-POP-03_столешница_рабочей_зоны.dxf
PK-POP-03
