horaanlika-droid/pacific/dxf/E6_zona_vydachi_perforirovannyy_lotok.dxf

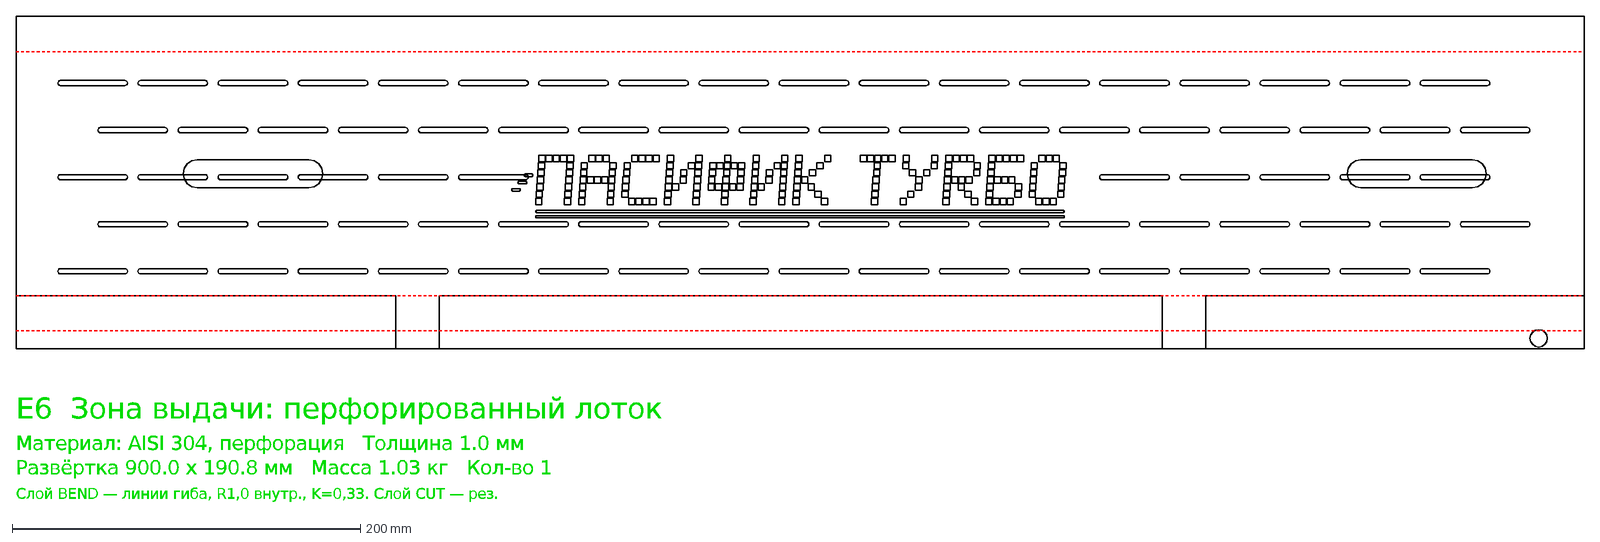
[picture p40: CAD file, 2026-11-08]
dxf/E6_zona_vydachi_perforirovannyy_lotok.dxf
E6 Зона выдачи: перфорированный лоток
Материал: AISI 304, перфорация Толщина 1.0 мм
Развёртка 900.0 x 190.8 мм Масса 1.03 кг Кол-во 1
Слой BEND — линии гиба, R1,0 внутр., K=0,33. Слой CUT — рез.
