horaanlika-droid/pacific/docs/flat/cnc/PK-FLAT-F2_bokovina_nizhnyaya.dxf

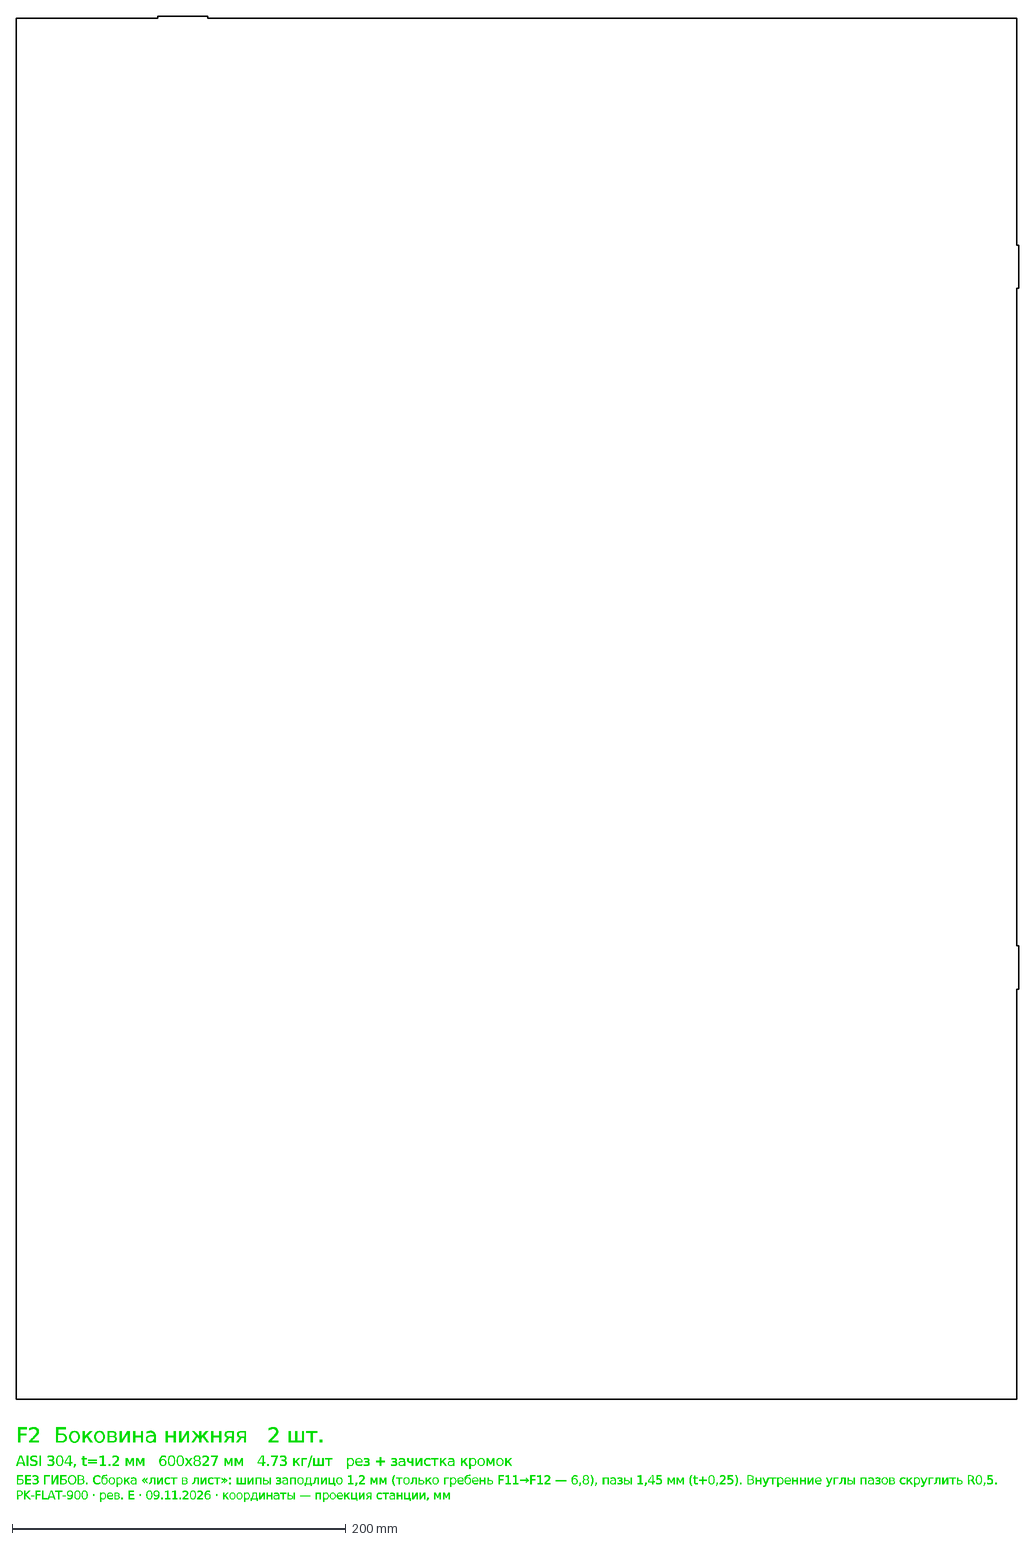
[picture p41: CAD file, 2026-11-09]
docs/flat/cnc/PK-FLAT-F2_bokovina_nizhnyaya.dxf
F2 Боковина нижняя 2 шт.
AISI 304, t=1.2 мм 600x827 мм 4.73 кг/шт рез + зачистка кромок
БЕЗ ГИБОВ. Сборка «лист в лист»: шипы заподлицо 1,2 мм (только гребень F11→F12 — 6,8), пазы 1,45 мм (t+0,25). Внутренние углы пазов скруглить R0,5.
PK-FLAT-900 · рев. E · 09.11.2026 · координаты — проекция станции, мм
