horaanlika-droid/pacific/docs/popup/cnc/PK-POP-04_фасадный_блок.dxf

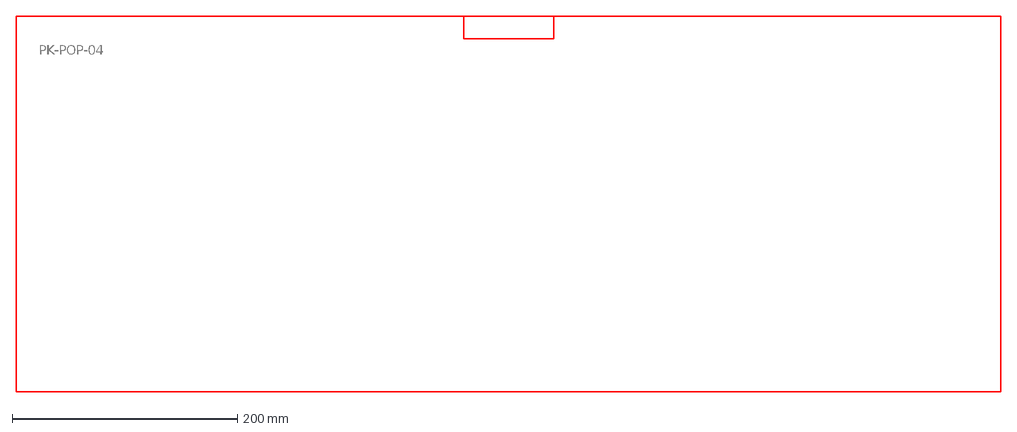
[picture p42: CAD file, 2026-11-08]
docs/popup/cnc/PK-POP-04_фасадный_блок.dxf
PK-POP-04
