horaanlika-droid/pacific/dxf/E3_fasadnyy_blok_nizhniy.dxf

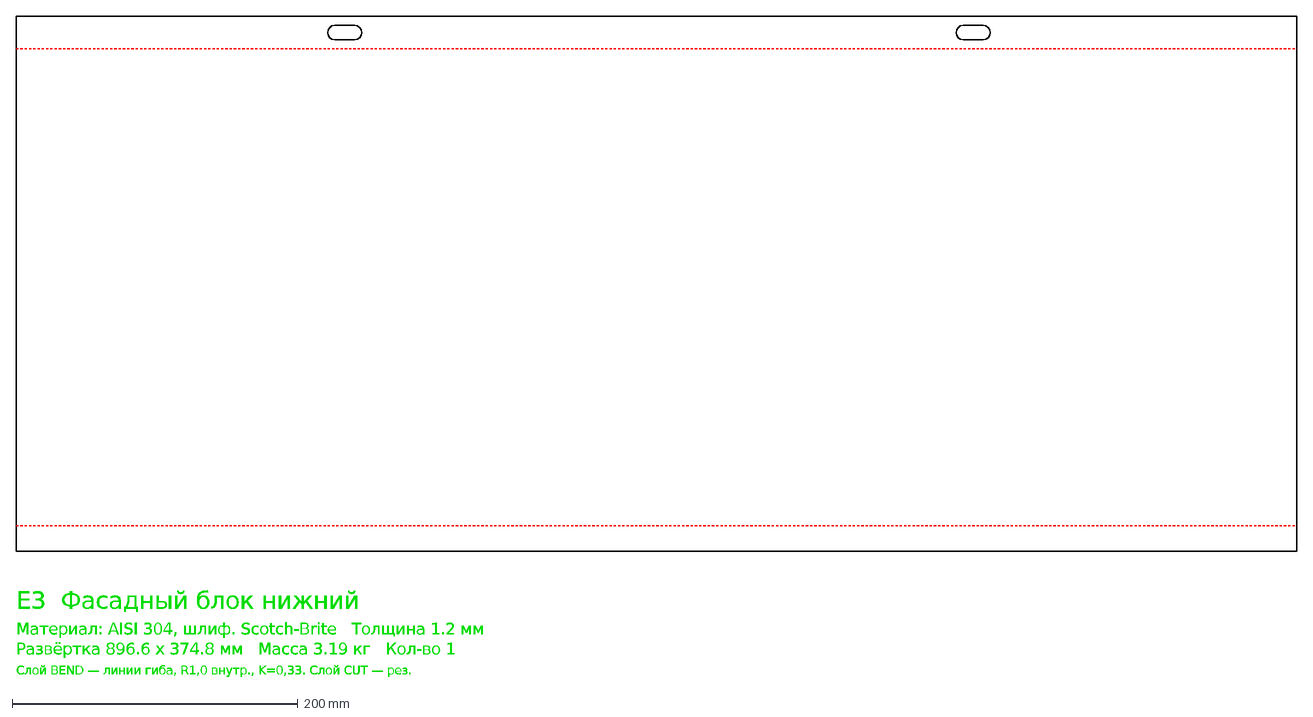
[picture p43: CAD file, 2026-11-08]
dxf/E3_fasadnyy_blok_nizhniy.dxf
E3 Фасадный блок нижний
Материал: AISI 304, шлиф. Scotch-Brite Толщина 1.2 мм
Развёртка 896.6 x 374.8 мм Масса 3.19 кг Кол-во 1
Слой BEND — линии гиба, R1,0 внутр., K=0,33. Слой CUT — рез.
