horaanlika-droid/pacific/docs/flat/cnc/PK-FLAT-F4_bortik_bokoviny_lotok.dxf

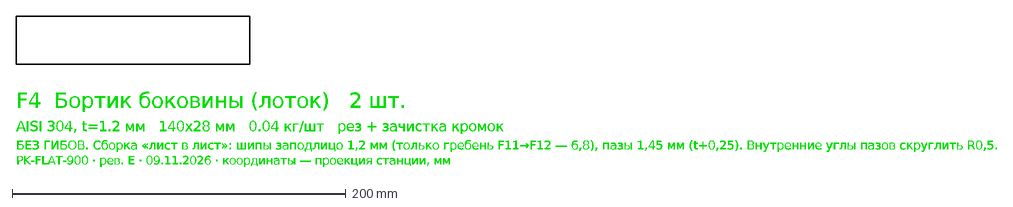
[picture p44: CAD file, 2026-11-09]
docs/flat/cnc/PK-FLAT-F4_bortik_bokoviny_lotok.dxf
F4 Бортик боковины (лоток) 2 шт.
AISI 304, t=1.2 мм 140x28 мм 0.04 кг/шт рез + зачистка кромок
БЕЗ ГИБОВ. Сборка «лист в лист»: шипы заподлицо 1,2 мм (только гребень F11→F12 — 6,8), пазы 1,45 мм (t+0,25). Внутренние углы пазов скруглить R0,5.
PK-FLAT-900 · рев. E · 09.11.2026 · координаты — проекция станции, мм
