horaanlika-droid/pacific/docs/popup/cnc/PK-POP-NEST_sheet2.dxf

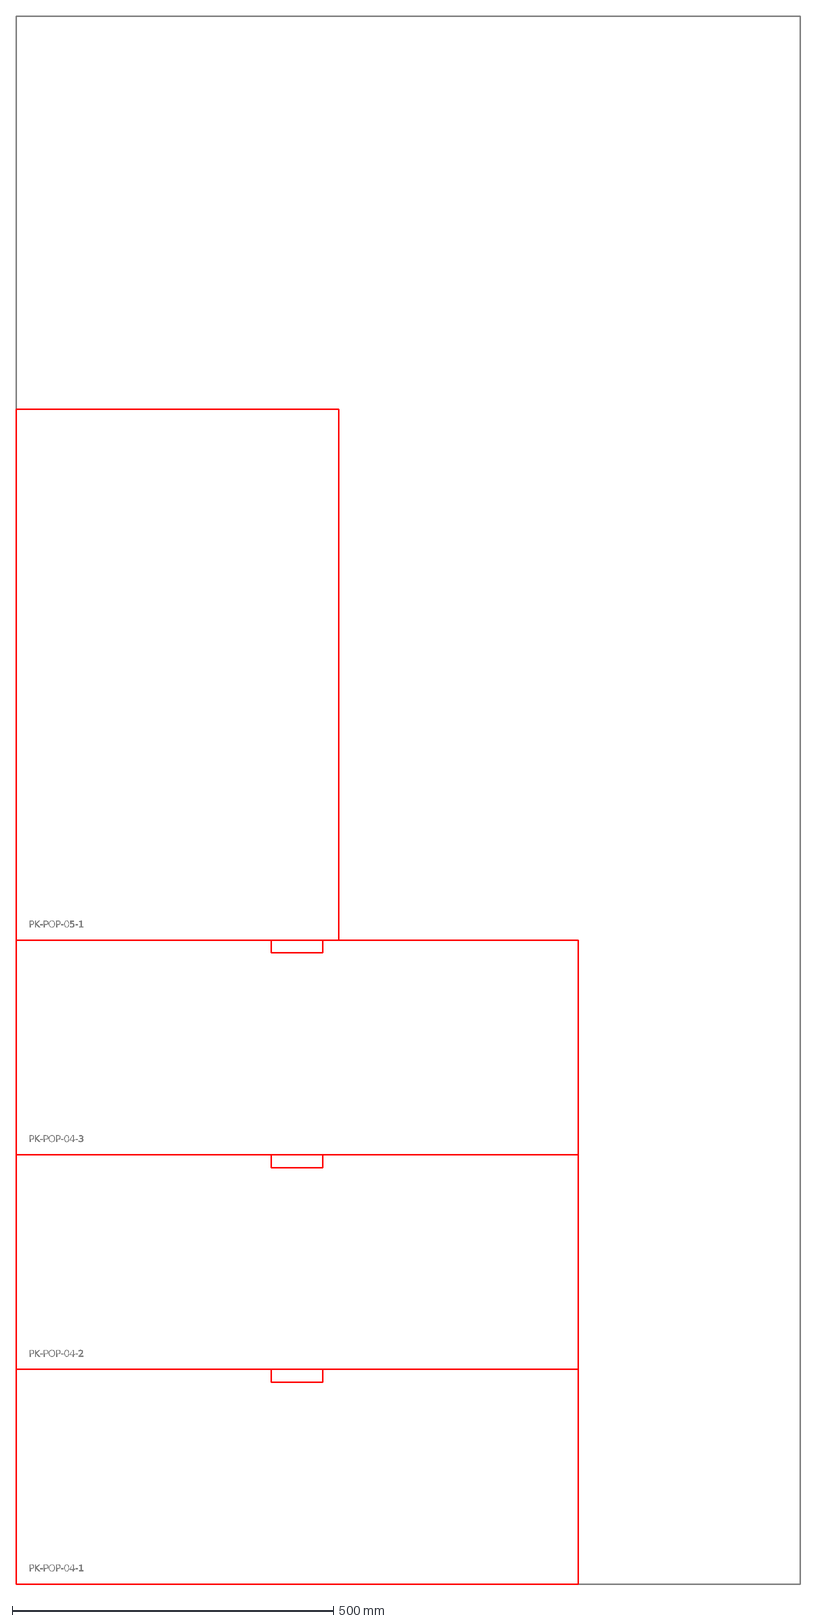
[picture p45: CAD file, 2026-11-08]
docs/popup/cnc/PK-POP-NEST_sheet2.dxf
PK-POP-04-1
PK-POP-04-2
PK-POP-04-3
PK-POP-05-1
