horaanlika-droid/pacific/dxf/PK-NEST_all_sheets.dxf

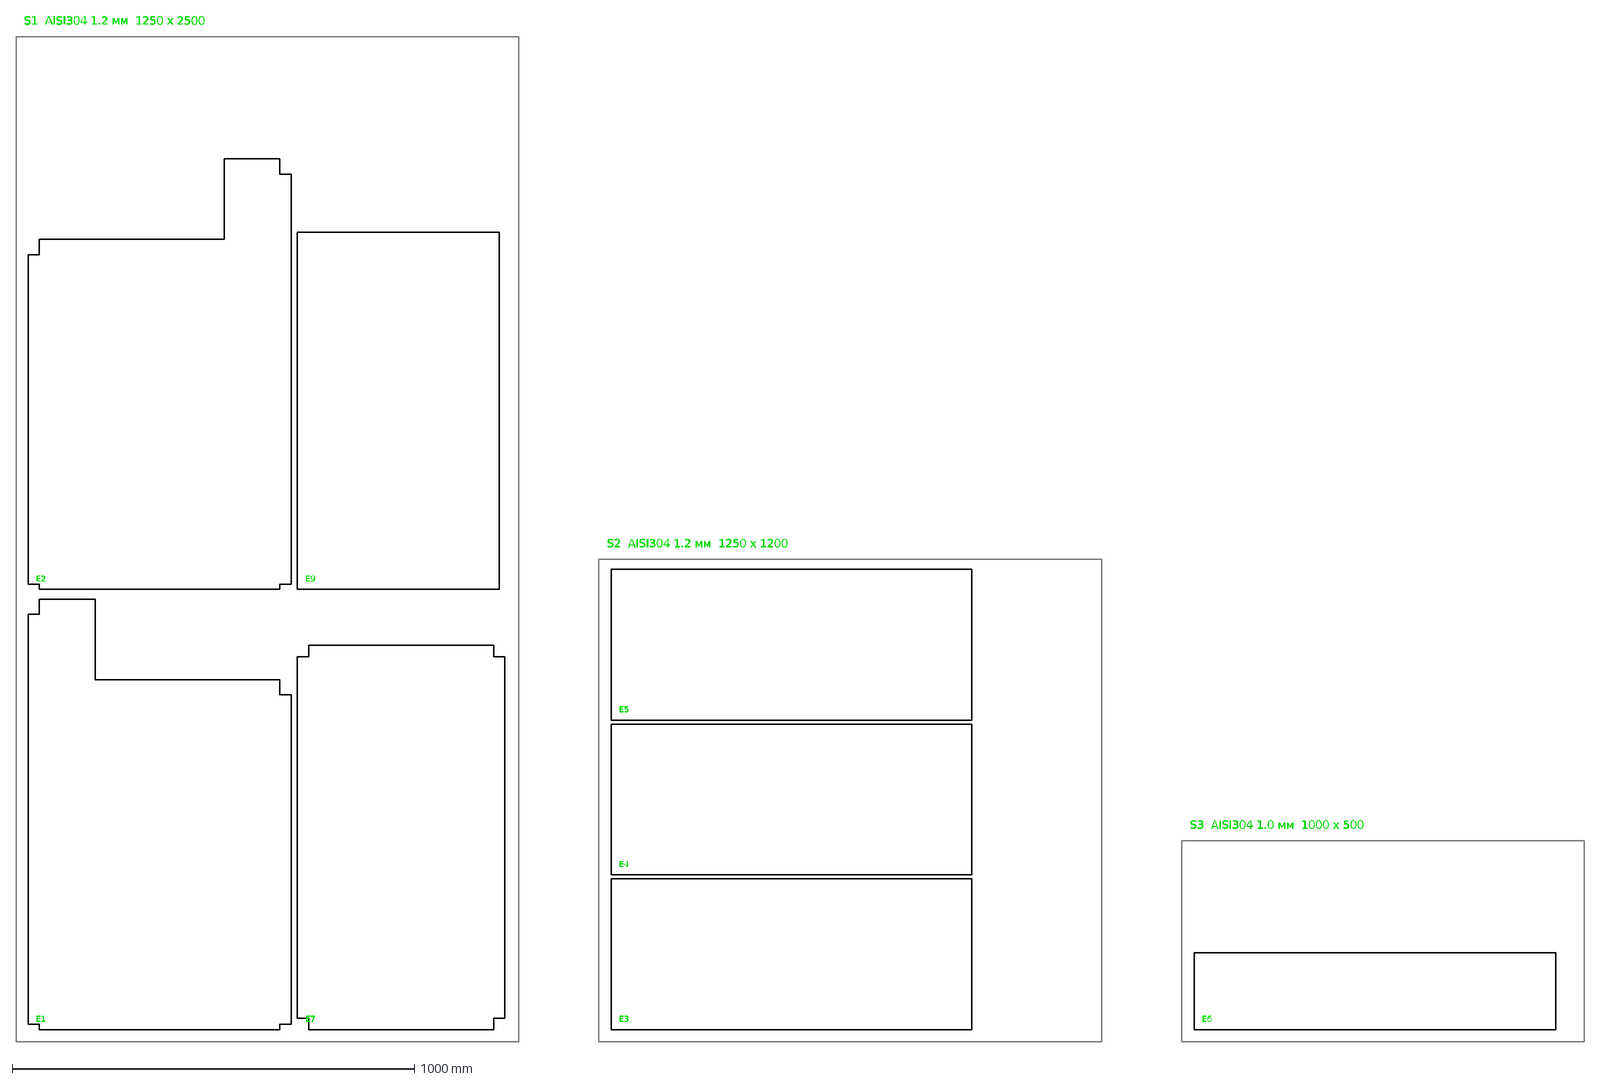
[picture p46: CAD file, 2026-11-08]
dxf/PK-NEST_all_sheets.dxf
S1 AISI304 1.2 мм 1250 x 2500
E1
E2
E7
E9
S2 AISI304 1.2 мм 1250 x 1200
E3
E4
E5
S3 AISI304 1.0 мм 1000 x 500
E6
