horaanlika-droid/pacific/docs/popup/cnc/PK-POP-05_перегородка.dxf

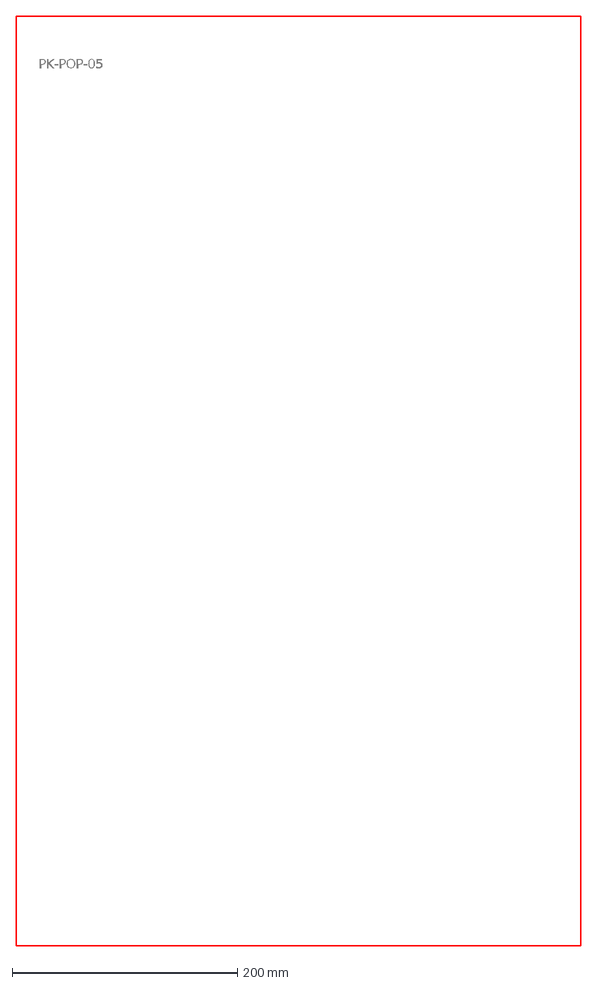
[picture p47: CAD file, 2026-11-08]
docs/popup/cnc/PK-POP-05_перегородка.dxf
PK-POP-05
