horaanlika-droid/pacific/dxf/E2_stenka_bokovaya_pravaya.dxf

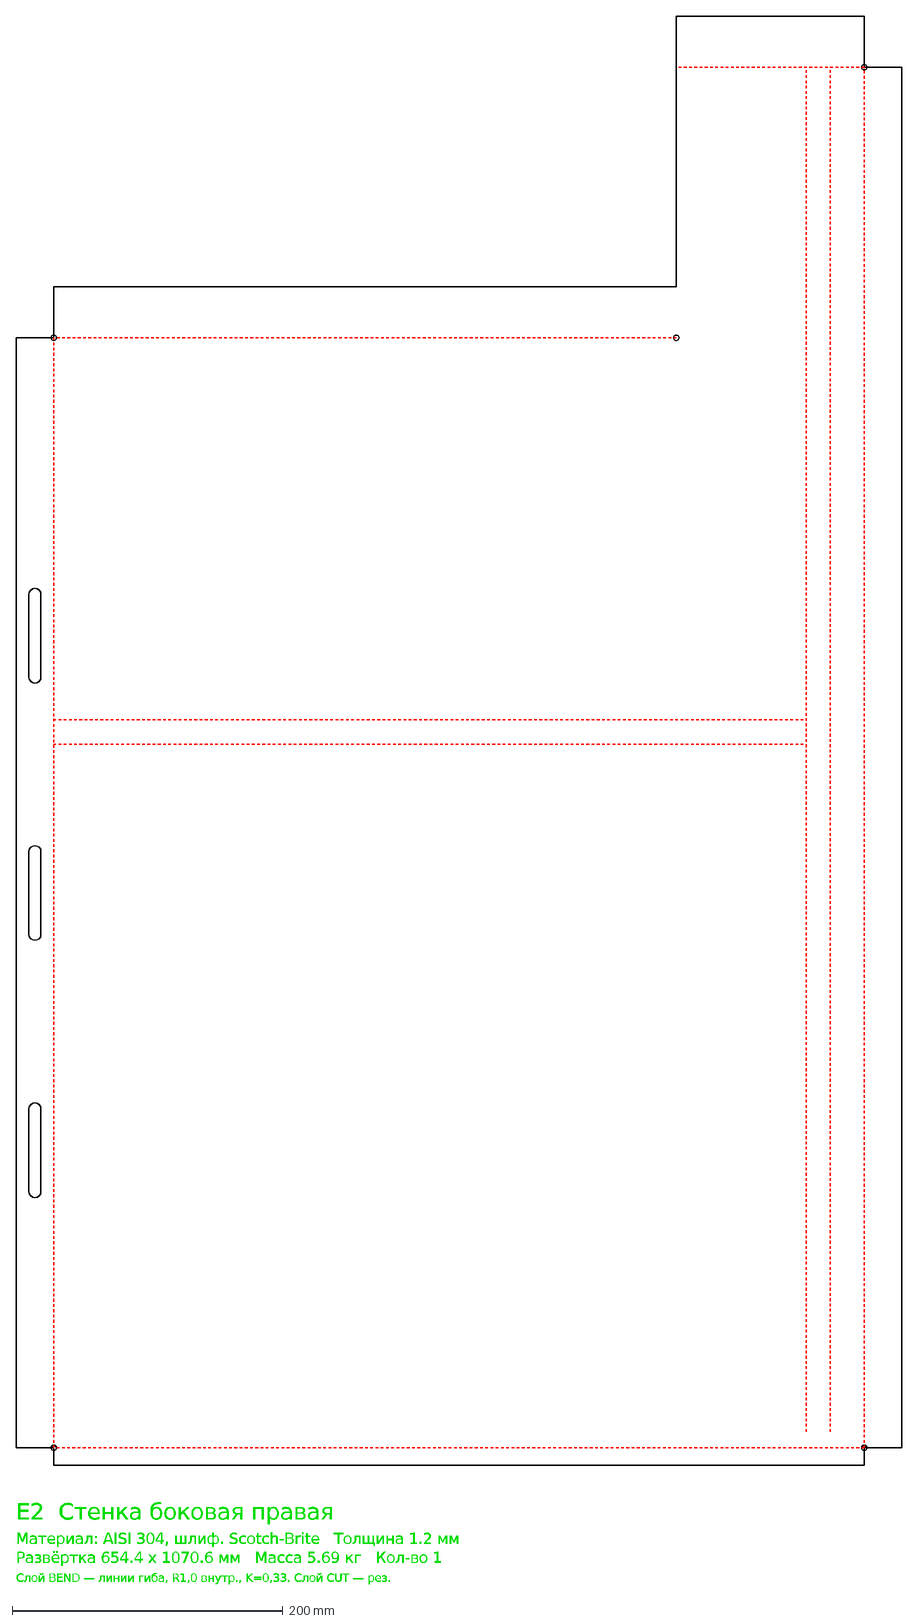
[picture p48: CAD file, 2026-11-08]
dxf/E2_stenka_bokovaya_pravaya.dxf
E2 Стенка боковая правая
Материал: AISI 304, шлиф. Scotch-Brite Толщина 1.2 мм
Развёртка 654.4 x 1070.6 мм Масса 5.69 кг Кол-во 1
Слой BEND — линии гиба, R1,0 внутр., K=0,33. Слой CUT — рез.
