horaanlika-droid/pacific/docs/flat/cnc/PK-FLAT-F6_stoleshnica.dxf

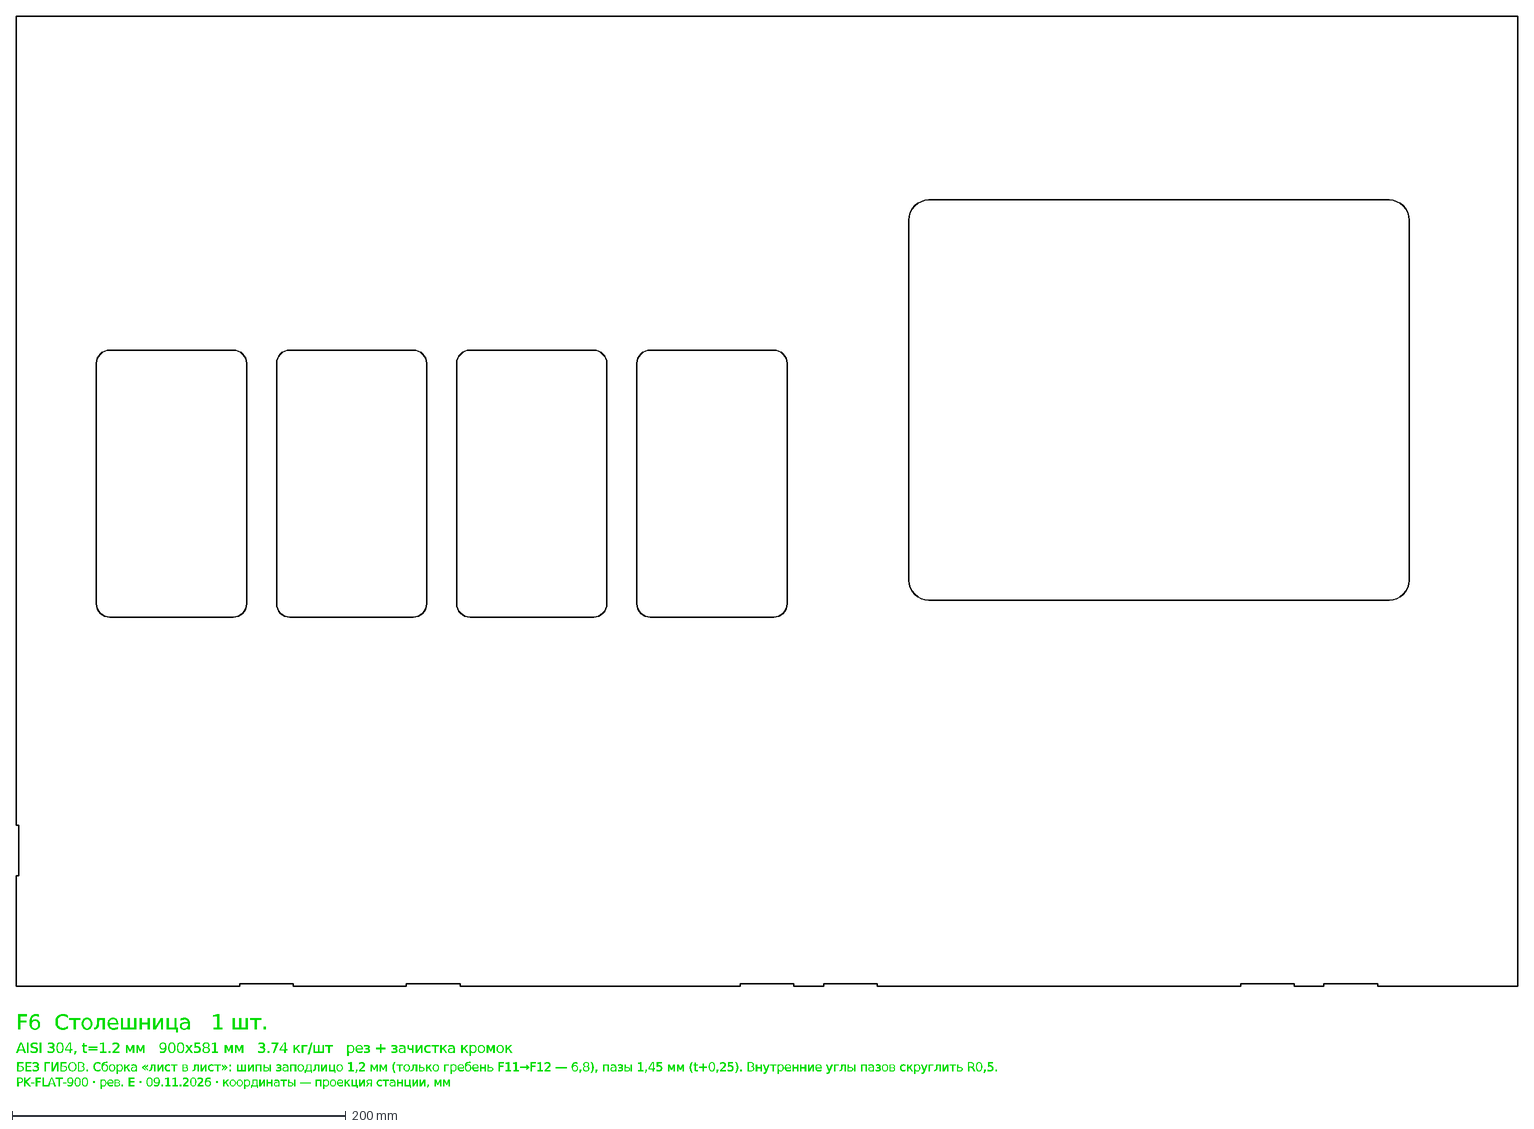
[picture p49: CAD file, 2026-11-09]
docs/flat/cnc/PK-FLAT-F6_stoleshnica.dxf
F6 Столешница 1 шт.
AISI 304, t=1.2 мм 900x581 мм 3.74 кг/шт рез + зачистка кромок
БЕЗ ГИБОВ. Сборка «лист в лист»: шипы заподлицо 1,2 мм (только гребень F11→F12 — 6,8), пазы 1,45 мм (t+0,25). Внутренние углы пазов скруглить R0,5.
PK-FLAT-900 · рев. E · 09.11.2026 · координаты — проекция станции, мм
