horaanlika-droid/pacific/docs/popup/cnc/PK-POP-02_дно.dxf

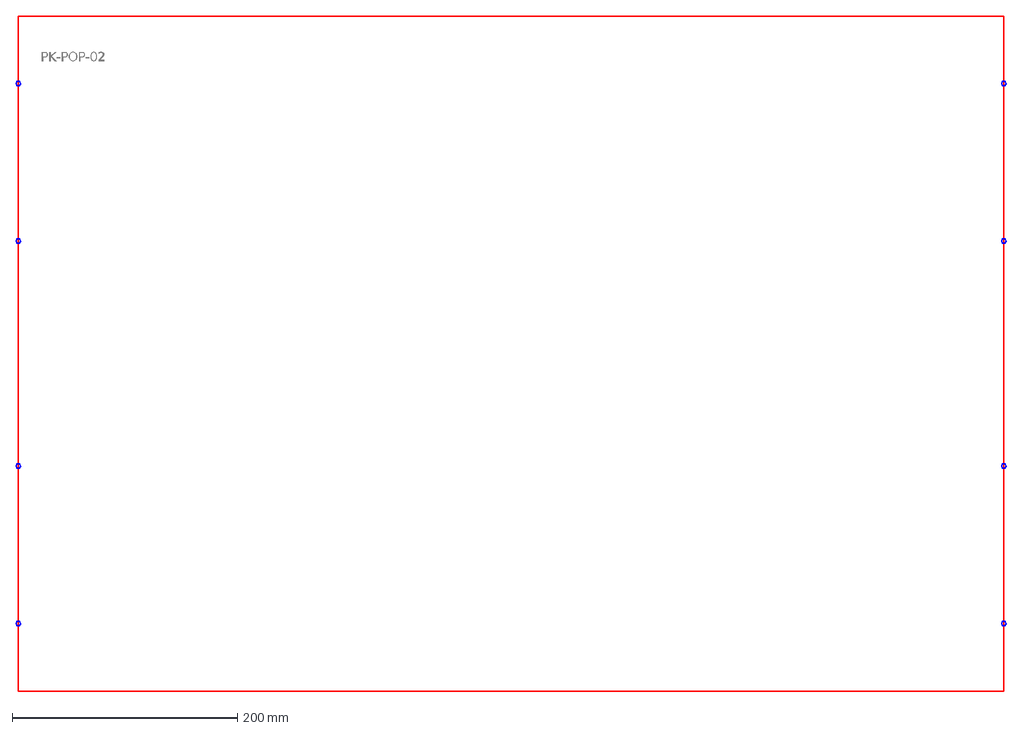
[picture p50: CAD file, 2026-11-08]
docs/popup/cnc/PK-POP-02_дно.dxf
PK-POP-02
