horaanlika-droid/pacific/dxf/E8.1_peregorodka_chehla.dxf

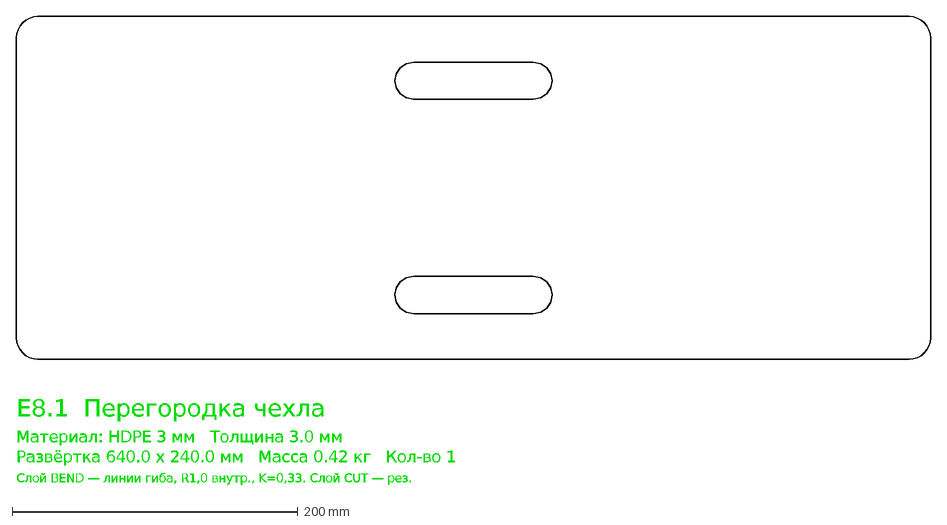
[picture p53: CAD file, 2026-11-08]
dxf/E8.1_peregorodka_chehla.dxf
E8.1 Перегородка чехла
Материал: HDPE 3 мм Толщина 3.0 мм
Развёртка 640.0 x 240.0 мм Масса 0.42 кг Кол-во 1
Слой BEND — линии гиба, R1,0 внутр., K=0,33. Слой CUT — рез.
