horaanlika-droid/pacific/(list of files, cad)

Other CAD files:
docs/flat/cnc/PK-FLAT-NEST_s1.dxf
docs/flat/cnc/PK-FLAT-NEST_s2.dxf
