horaanlika-droid/pacific/docs/visualization/sborka/PK-900_step1_sides.png

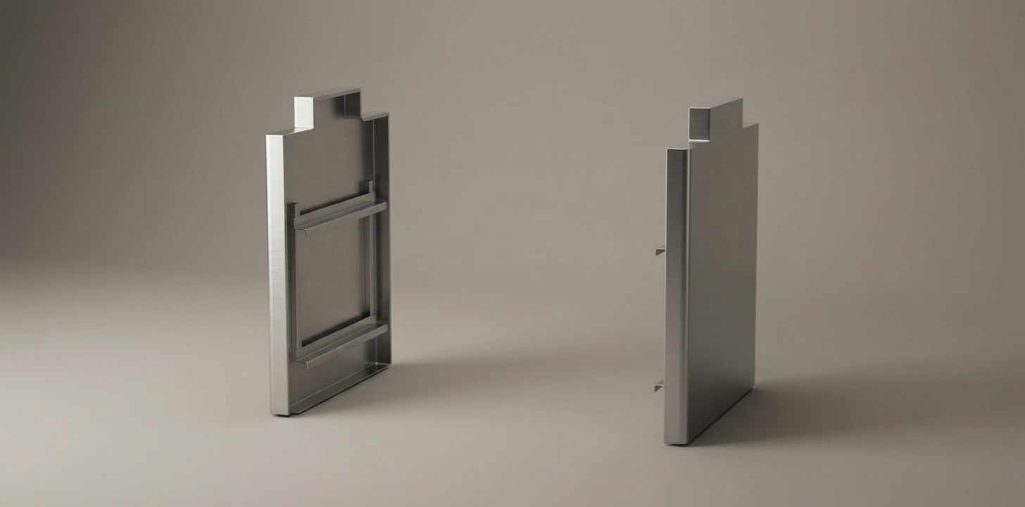
docs/visualization/sborka/PK-900_step1_sides.png
