horaanlika-droid/pacific/docs/visualization/sborka/PK-900_step4_countertop.png

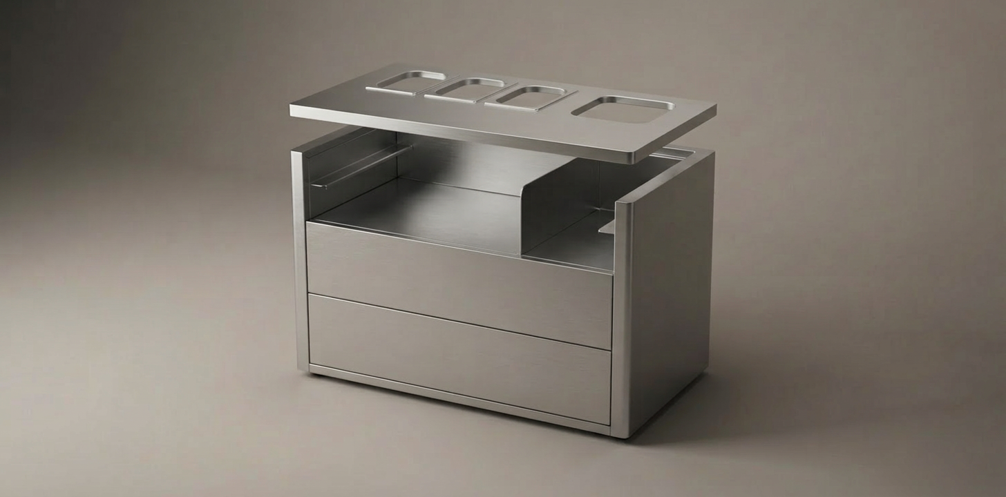
docs/visualization/sborka/PK-900_step4_countertop.png
