horaanlika-droid/pacific/(commit log)

2026-11-08 ПАСИФИК КИТ: параметрическая модель, DXF на лазер и альбом проекта
    - cad/pk_geom.py — геометрия 8 элементов (900 × 600 × 1050), развёртки, K = 0,33
    - cad/pk_dxf.py — 12 DXF (CUT/BEND/INFO/SHEET) + раскладка на 3 листа + INDEX
    - cad/pk_draw.py, cad/pk_album.py — альбом A3, 14 листов
    - docs/ПАСИФИК_КИТ_альбом.pdf — общие виды, развёртки, узлы, чехол, сборка, производство
    - README.md — состав, сборка, ключевые решения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
    [E1_stenka_bokovaya_levaya.dxf, E2_stenka_bokovaya_pravaya.dxf, E3_fasadnyy_blok_nizhniy.dxf, E4_fasadnyy_blok_sredniy.dxf, E5_fasadnyy_blok_verhniy.dxf, E6.1_lotok_nizhniy_list.dxf, E6_zona_vydachi_perforirovannyy_lotok.dxf, E7_rabochaya_zona_stoleshnica_s_vyrezami.dxf]
2026-11-08 визуализация: лоток выдачи на верхней плоскости, рабочая поверхность утоплена на 60 мм, чаши объёмом, нумерация взрыв-схемы
2026-11-08 gitignore: убрать __pycache__ из репозитория
2026-11-08 рев. B: рабочая поверхность утоплена до 990, борт выдачи 1050, ледник сдвинут влево (435…755); альбом, DXF и визуализация пересобраны
    [E1_stenka_bokovaya_levaya.dxf, E2_stenka_bokovaya_pravaya.dxf, E3_fasadnyy_blok_nizhniy.dxf, E4_fasadnyy_blok_sredniy.dxf, E5_fasadnyy_blok_verhniy.dxf, E6.1_lotok_nizhniy_list.dxf, E6_zona_vydachi_perforirovannyy_lotok.dxf, E7_rabochaya_zona_stoleshnica_s_vyrezami.dxf]
2026-11-08 Опущена рабочая поверхность до 850 мм (на высоту бедра), ступенчатые боковины 1020/820
    [E1_stenka_bokovaya_levaya.dxf, E2_stenka_bokovaya_pravaya.dxf, E3_fasadnyy_blok_nizhniy.dxf, E4_fasadnyy_blok_sredniy.dxf, E5_fasadnyy_blok_verhniy.dxf, E6.1_lotok_nizhniy_list.dxf, E6_zona_vydachi_perforirovannyy_lotok.dxf, E7_rabochaya_zona_stoleshnica_s_vyrezami.dxf]
2026-11-08 Столешница E7: 4 отсека под гастроёмкости GN 1/9 и двухсекционная раковина
    [E1_stenka_bokovaya_levaya.dxf, E2_stenka_bokovaya_pravaya.dxf, E3_fasadnyy_blok_nizhniy.dxf, E4_fasadnyy_blok_sredniy.dxf, E5_fasadnyy_blok_verhniy.dxf, E6.1_lotok_nizhniy_list.dxf, E6_zona_vydachi_perforirovannyy_lotok.dxf, E7_rabochaya_zona_stoleshnica_s_vyrezami.dxf]
2026-11-08 Revise Pacific Turbo workstation design
    [E1_stenka_bokovaya_levaya.dxf, E2_stenka_bokovaya_pravaya.dxf, E3_fasadnyy_blok_nizhniy.dxf, E4_fasadnyy_blok_sredniy.dxf, E5_fasadnyy_blok_verhniy.dxf, E6.1_lotok_nizhniy_list.dxf, E6_zona_vydachi_perforirovannyy_lotok.dxf, E7_rabochaya_zona_stoleshnica_s_vyrezami.dxf]
2026-11-08 PK-900: убран кран, добавлена внутренняя перегородка E9 (зона льда / мойка), обновлены DXF, рендер, альбом
    [E1_stenka_bokovaya_levaya.dxf, E2_stenka_bokovaya_pravaya.dxf, E3_fasadnyy_blok_nizhniy.dxf, E4_fasadnyy_blok_sredniy.dxf, E5_fasadnyy_blok_verhniy.dxf, E6_zona_vydachi_perforirovannyy_lotok.dxf, E7_rabochaya_zona_stoleshnica_s_vyrezami.dxf, E8.1_peregorodka_chehla.dxf]
2026-11-08 Смета рев. D: без чехла, без зачистки и сборки; только резка и гибка
2026-11-08 рев. D: листы 1,2 мм, жёсткость рёбрами (боковины, столешница, перегородка), чехол убран из рендера, DXF и смета
    [E1_stenka_bokovaya_levaya.dxf, E2_stenka_bokovaya_pravaya.dxf, E3_fasadnyy_blok_nizhniy.dxf, E4_fasadnyy_blok_sredniy.dxf, E5_fasadnyy_blok_verhniy.dxf, E6_zona_vydachi_perforirovannyy_lotok.dxf, E7_rabochaya_zona_stoleshnica_s_vyrezami.dxf, E8.1_peregorodka_chehla.dxf]
2026-11-08 рев. D+: рельсы на боковинах под фасады, без крючков; перегородка сдвинута; логотип крупнее с полосами; смета и README
    [E1_stenka_bokovaya_levaya.dxf, E2_stenka_bokovaya_pravaya.dxf, E3_fasadnyy_blok_nizhniy.dxf, E4_fasadnyy_blok_sredniy.dxf, E5_fasadnyy_blok_verhniy.dxf, E6_zona_vydachi_perforirovannyy_lotok.dxf, E7_rabochaya_zona_stoleshnica_s_vyrezami.dxf, E9_peregorodka_vnutrennyaya.dxf]
2026-11-08 предметная фотосъёмка PK-900 в стиле Margiela (по геометрии и чертежам)
2026-11-08 PK-900: ракурсы фото (спереди-справа, сзади-слева)
2026-11-08 фото-сборка PK-900 по шагам (5 кадров) и концепция попап-версии из фанеры 12 мм
2026-11-08 попап PK-POP-900: DXF для ЧПУ (6 деталей, раскрой 2 листа 1220x2440), схемы, презентация (9 слайдов), концепция рев. 1
    [PK-POP-01_боковина.dxf, PK-POP-02_дно.dxf, PK-POP-03_столешница_рабочей_зоны.dxf, PK-POP-04_фасадный_блок.dxf, PK-POP-05_перегородка.dxf, PK-POP-06_рейка_направляющей.dxf, PK-POP-NEST_sheet1.dxf, PK-POP-NEST_sheet2.dxf]
2026-11-08 попап: плита выдачи из фанеры 12 мм (PK-POP-07, слоты и логотип), боковины 1038, презентация и концепция рев. 2
    [PK-POP-01_боковина.dxf, PK-POP-02_дно.dxf, PK-POP-03_столешница_рабочей_зоны.dxf, PK-POP-04_фасадный_блок.dxf, PK-POP-05_перегородка.dxf, PK-POP-06_рейка_направляющей.dxf, PK-POP-07_выдача.dxf, PK-POP-NEST_sheet1.dxf]
2026-11-09 Update plywood popup cutouts for 6 mm router
    [PK-POP-07_выдача.dxf, PK-POP-NEST_sheet1.dxf]
2026-11-09 PK-FLAT-900 рев. E: плоский конструктор без гибов — геометрия, DXF, альбом
    - cad/pk_flat.py: 13 деталей / 18 шт., 4 узла (шлиц-стык, шип-паз, гребень,
    сэндвич лотка); шипы заподлицо 1,2 мм (глубокий — только гребень F11→F12 6,8),
    пазы 1,45 мм; проверки кромок и объёмов (шипы не входят в чужие детали)
    - cad/pk_flat_dxf.py: 13 DXF 1:1 + раскрой на 2 листа 1250×2500
    - cad/pk_flat_album.py: альбом A3 на 6 листов (узлы, слои, спецификация,
    сборка, смет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
    [PK-FLAT-F10_lozhnoe_dno_lotka_perforaciya_logotip.dxf, PK-FLAT-F11_fasad_nizhniy.dxf, PK-FLAT-F12_fasad_verhniy_barer.dxf, PK-FLAT-F13_zadnyaya_panel.dxf, PK-FLAT-F14_peregorodka_led___moyka.dxf, PK-FLAT-F1_plintus_bokoviny.dxf, PK-FLAT-F2_bokovina_nizhnyaya.dxf, PK-FLAT-F3_stoyka_bokoviny.dxf]
