horaanlika-droid/pacific/IMG_1841.jpeg

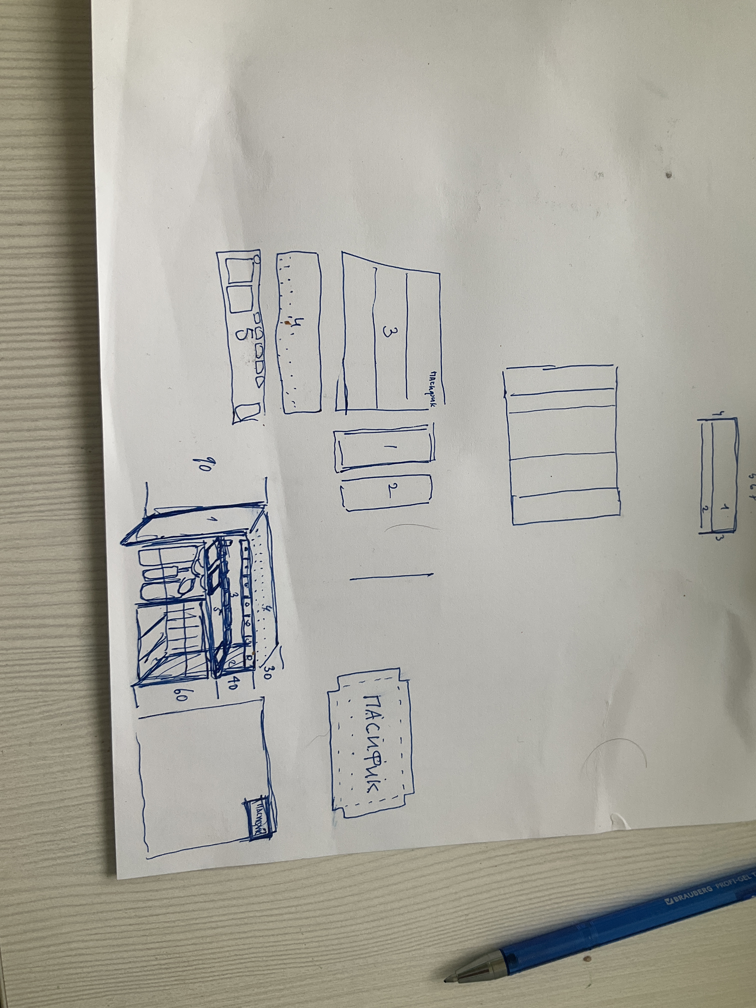
IMG_1841.jpeg
